MrEngineerET/roboClean/Documentation/Images/Progress/Final Hardware/DSC_0028.JPG

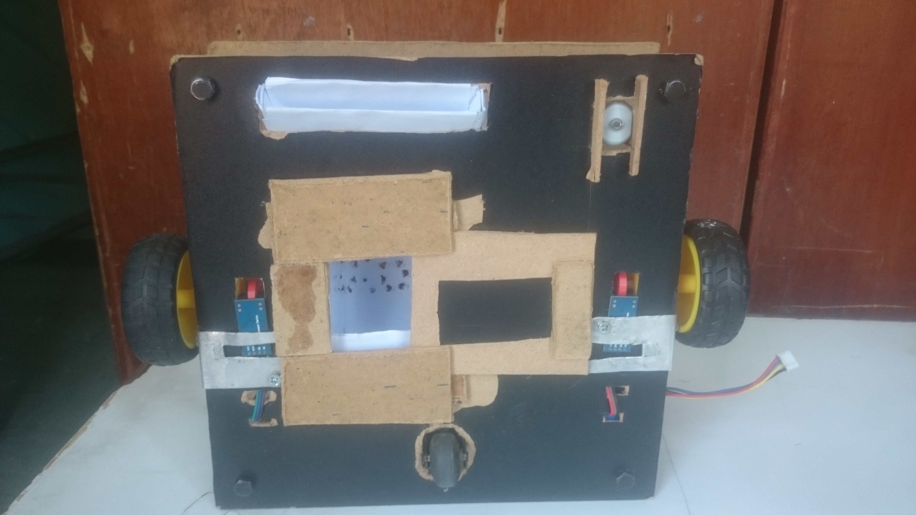
Documentation/Images/Progress/Final Hardware/DSC_0028.JPG
