MrEngineerET/roboClean/Documentation/Images/Progress/Hardware/phase three/photo_2020-12-10_14-24-15.jpg

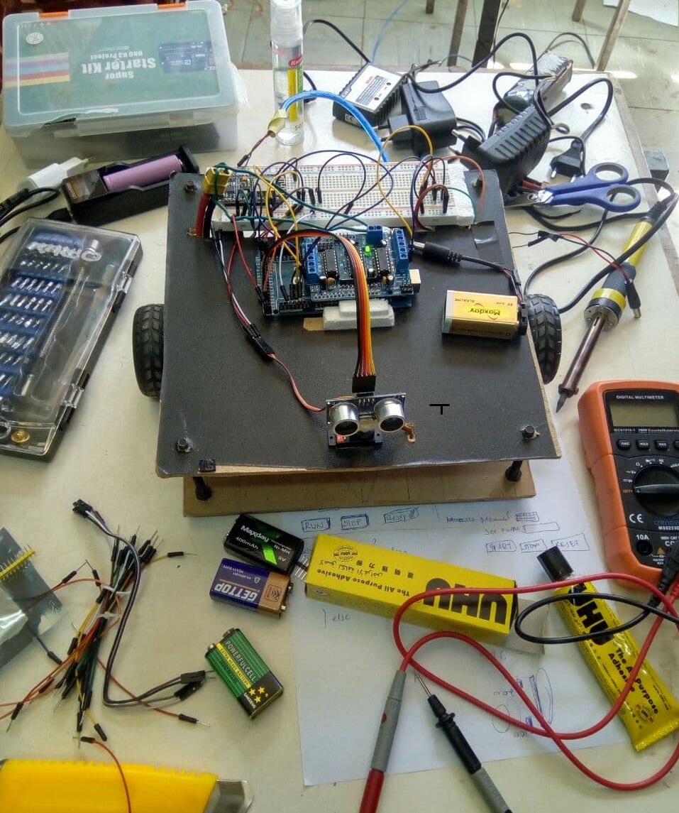
Documentation/Images/Progress/Hardware/phase three/photo_2020-12-10_14-24-15.jpg
