MrEngineerET/roboClean/Documentation/Autonomous Vacuum Cleaner Robot -Thesis presentation.pptx

## Autonomous Vacuum Cleaner Robot

Biruk Berhanu
Advisor: Mr. Kinde Mekuria

## Overview

- Introduction
- Background
- Problem statement
- Objectives
- Methodology
- Mathematical Modeling

- Odometry
- Control System Design
- Simulation/Design
- Result and Discussion
- Conclusion
- Future Work

## Introduction

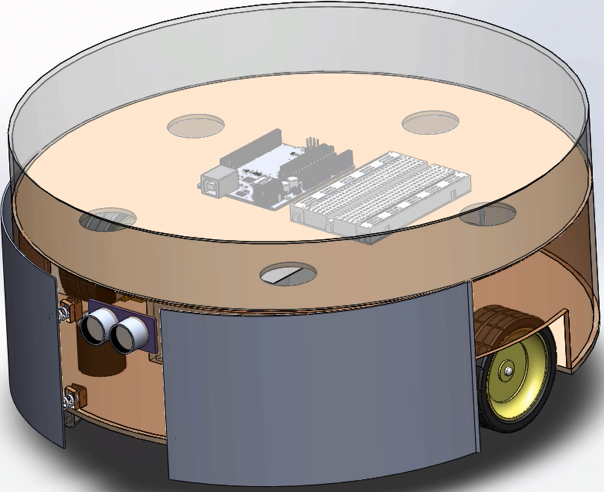
[picture p3: figure]

- It uses vacuum to clean dirt
- It navigates both autonomously and manually
- Can be Implemented at low cost using readily
available material

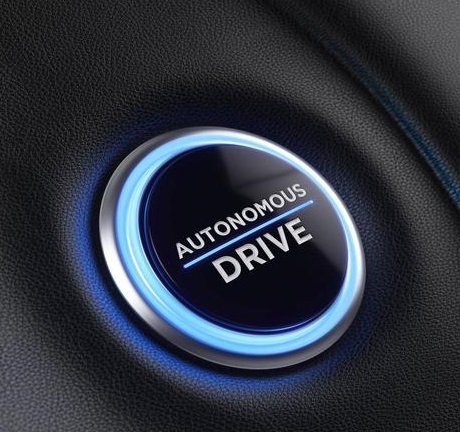
[picture p4: figure]

## Introduction Cont’d

- Theoretical Background
  - Mathematical Modeling
  - Control Theory
  - Sensing

  - localization
  - Mapping
  - Path Planning

## Background

- Roomba is one of the most widely used vacuum cleaning robots
- Other brand costs
between $400-$900

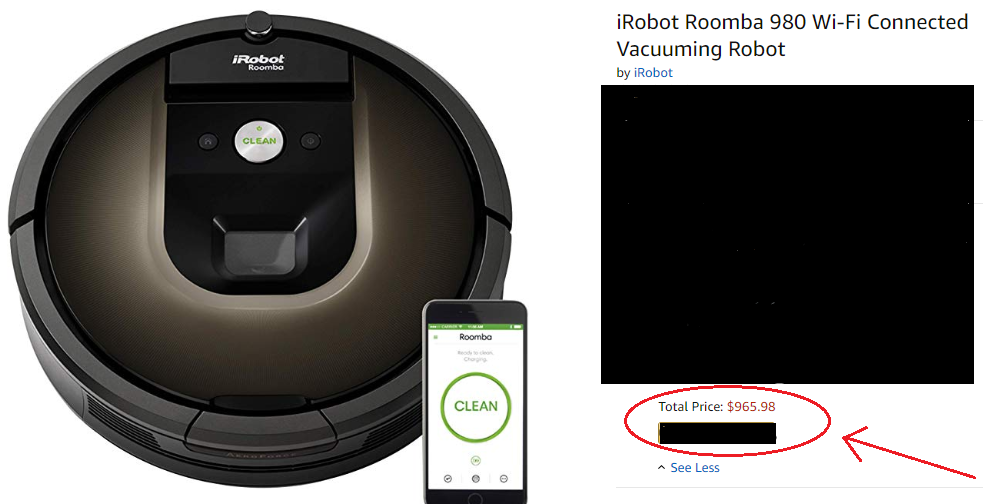
[picture p5: figure]

## Background Cont’d

- T.B. Asafa, T.M. Afonja, E.A. Olaniyan, H.O. Alade October
2016 Ladoke Akintola University of Technology, Nigeria
- CesNieto : https://www.instructables.com/id/Build-Your-Own-Vacuum-Robot/

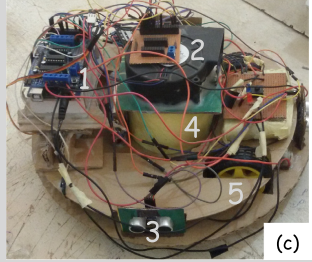
[picture p6: figure]
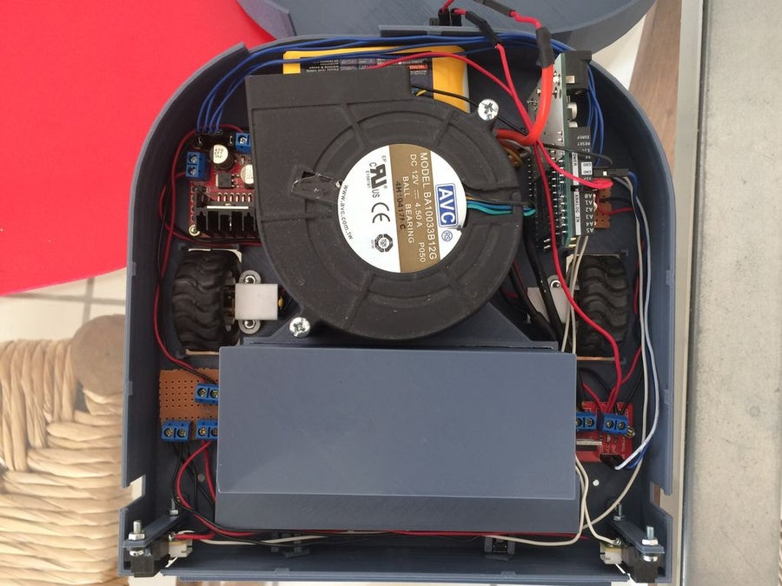
[picture p7: figure]

## Problem statement

- Price of the vacuum cleaner in the market
- The research made in university and technology enthusiast
  - Big in size
  - Low vacuum cleaning power
  - Inefficient algorithm for navigation

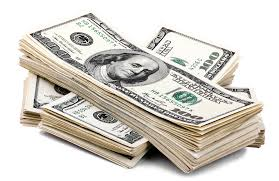
[picture p8: figure]

## Objectives

  - Low Price
  - Efficient navigation
  - Small in Size
  - Power efficient

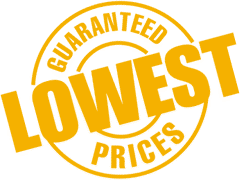
[picture p9: figure]

## Methodology

Driving Mechanism
  - Two DC motor controlled wheel
  - One caster wheel for balancing
at the bottom rear

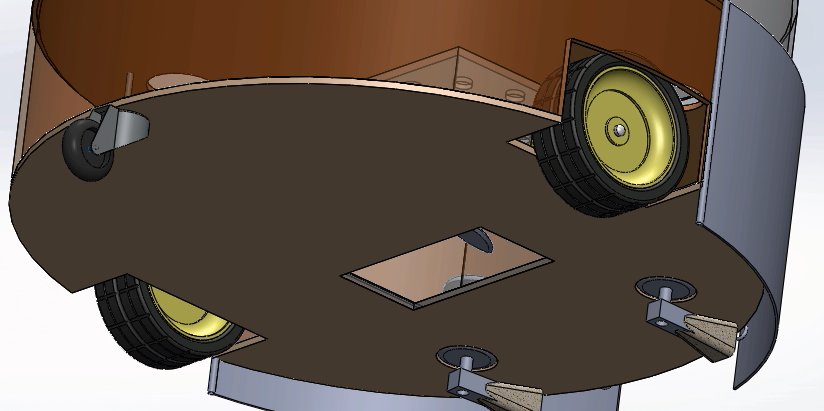
[picture p10: figure]

## Methodology Cont’d

- Cleaning Mechanism
  - One DC-motor driven for creating
a vacuum region
  - One DC-motor driven sweeper

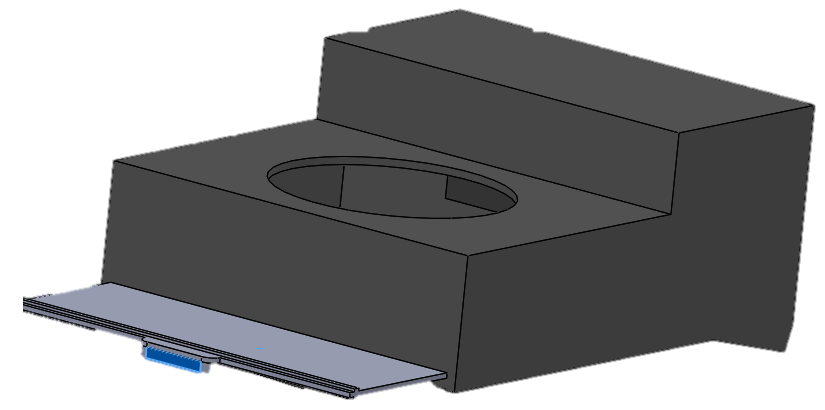
[picture p11: figure]
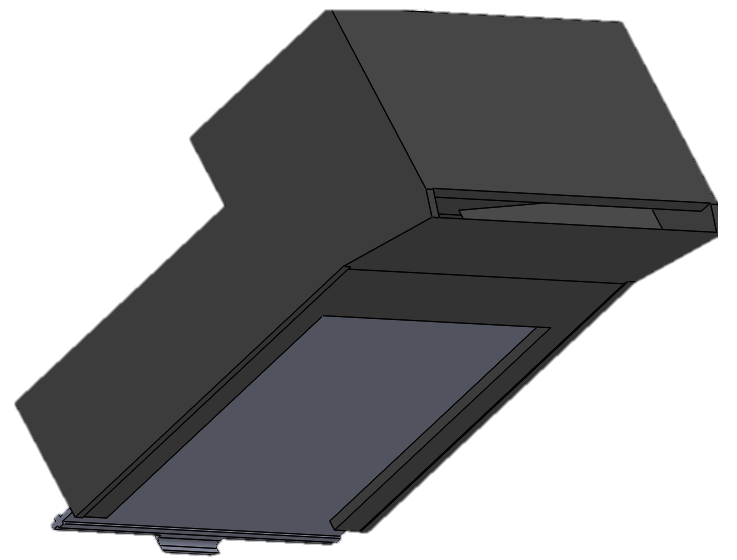
[picture p12: figure]

## Methodology Cont’d

- Navigation
  - Two mode of operation
    - Autonomously
    - Manually using Web
Random Walk
  - The robot navigates freely
without any control.

## Methodology Cont’d

- Controlled path(Method 1)
  - The robot moves only
orthogonally to the wall
  - uses the whole room as
one rectangle

## Methodology Cont’d

- Controlled path(Method 2)
  - Divide the house into numbers
of rectangles

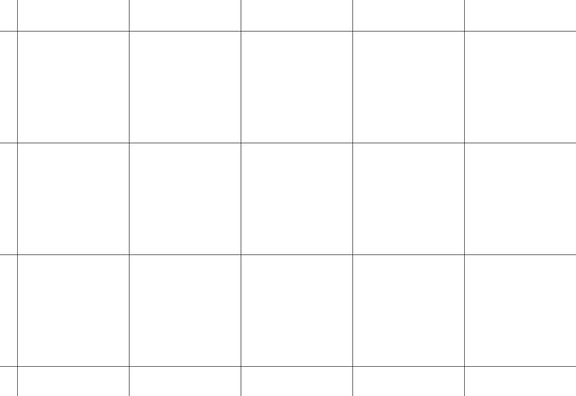
[picture p13: figure]

## Mathematical Modeling

- Modeling the robot as a differential drive robot
- The differential drive is a two-wheeled drive
with independent actuators for each wheel.
        - x`=1/2(Vr+Vl)cosφ
        - y`=1/2(Vr+Vl) sinφ
        - φ`=1/L ( Vr+Vl )

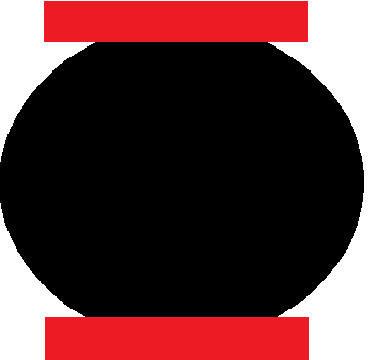
[picture p14: figure]

L

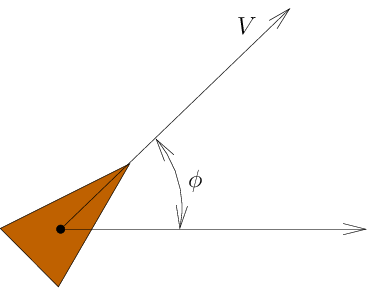
[picture p15: figure]

## Mathematical Modeling Cont’d

Simplification to the modeling
- Using Unicycle Modeling
        - x`=Vcosφ
        - y`=Vsinφ
        - φ`=ω

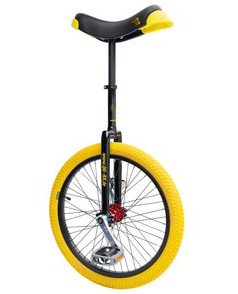
[picture p16: figure]

## Mathematical Modeling Cont’d

Design Model Implementation model
x`=Vcosφ x`=((Vr+Vl)/2)cosφ
y`=Vsinφ y`=((Vr+Vl)/2)sinφ
φ`=ω φ`=(Vr−Vl)/L
Using these two equation we can get the relation from (V,w) to (Vr,Vl)
Vr=(2V+ ωL)/2
Vl=(2V− ωL)/2

## Mathematical Modeling Cont’d

- Even though the Unicycle modeling makes a simplification to our work, It is still not convenient for solving path planning problem
High Level Modeling

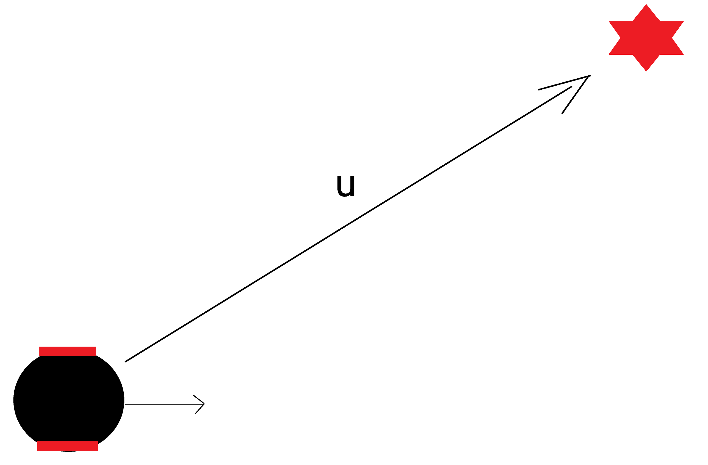
[picture p17: figure]

p `=u, x∊ R²
u=[u_x ,u_y ]
x`=[x_1 ,y_1 ]

## Mathematical Modeling Cont’d

- φ_d =atan⁡((u_y)/(u_x))
- V= √(u_y +u_x)
- ω=PID(e)=K_p e+ K_i ∫_0^τ e(t)dτ+(K_d e(t))/(dt) e= φ_d − φ

## Odometry

- where am I ?
- Where am I heading ?
Ans: Wheel encoder ( both for heading and position )

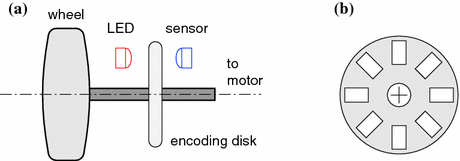
[picture p18: figure]

## Odometry Cont’d

x`=x+d_(center) cosΘ
y`=y+d_(center) sinΘ
Θ`= Θ+ φ
φ= (d_(right) −d_(left) )/L

## Odometry Cont’d

How do we calculate dr, dl ?
Ans:
D = 2 π R(Δtick /N)
Where R is radius,
N is number of opening slots in the encoding disk,
D is either dl or dr with a respective Δtick,

## Control System Design

I used PID controller for controlling the motion of the robot.

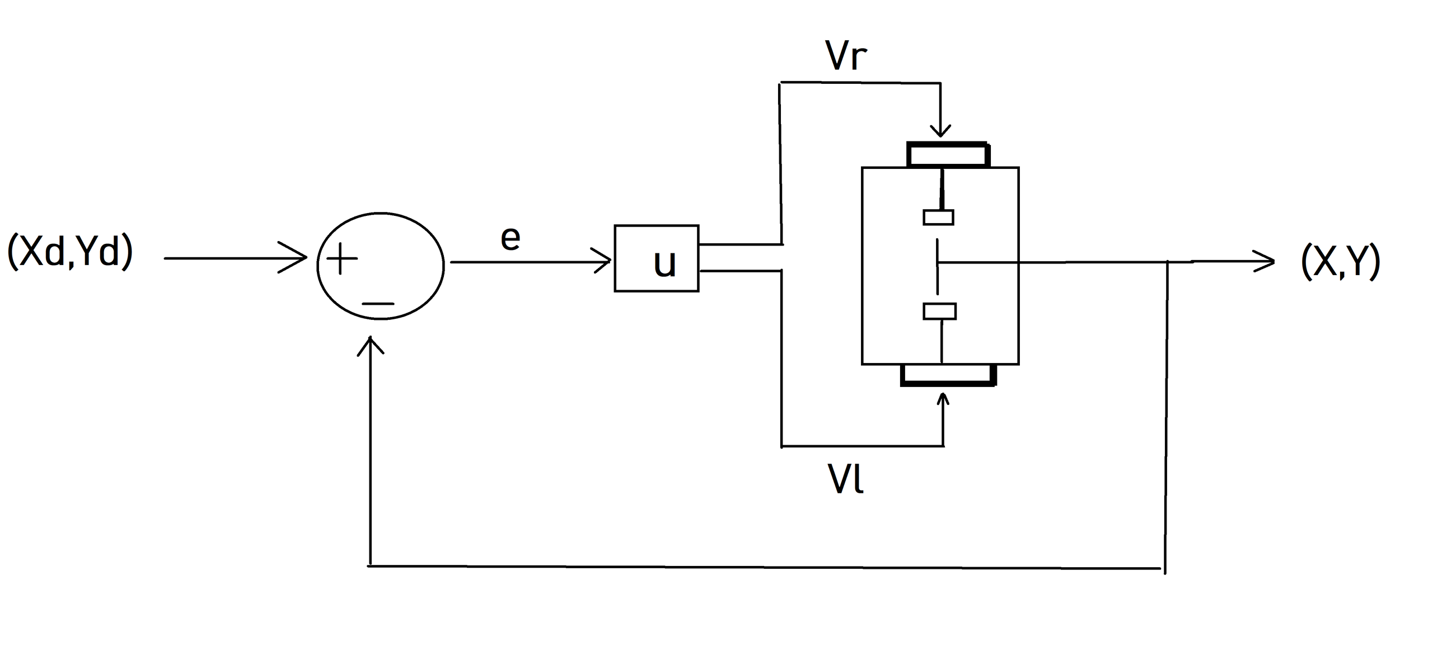
[picture p19: figure]

## Result

Go To Goal Behavior
With PID parameters of
Kp = 2
Ki = 0.05
Kd = 0

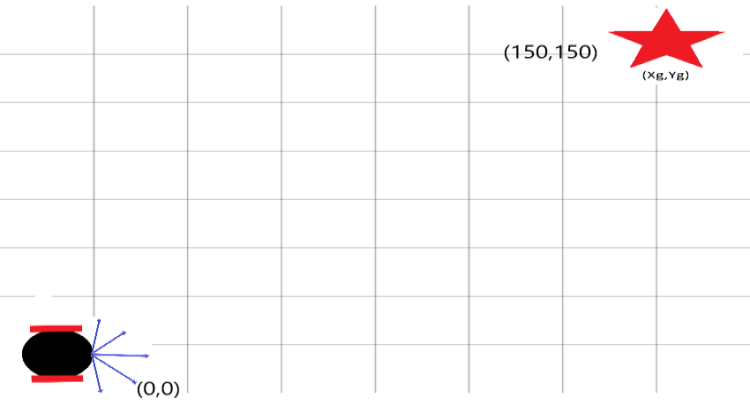
[picture p20: figure]

## Slide 24

- Position of the robot

Result cont’d (Go To Goal Behavior)

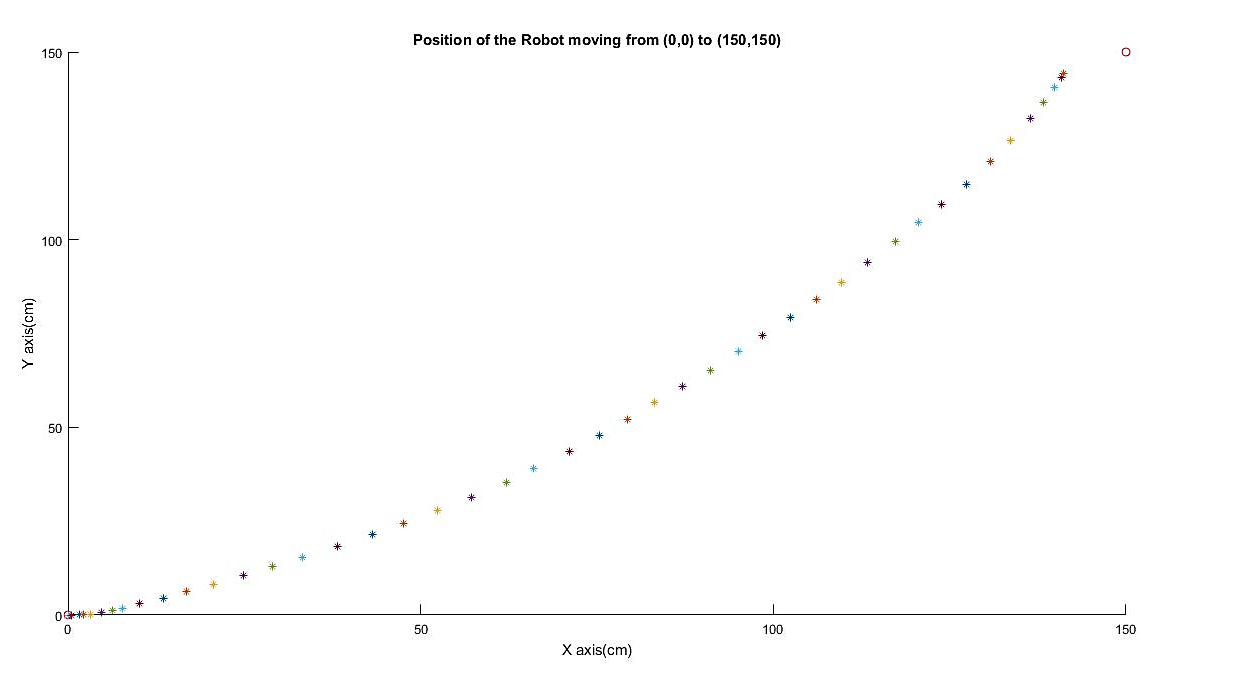
[picture p21: figure]

## Result cont’d (Go To Goal Behavior)

Tracking of the angle response

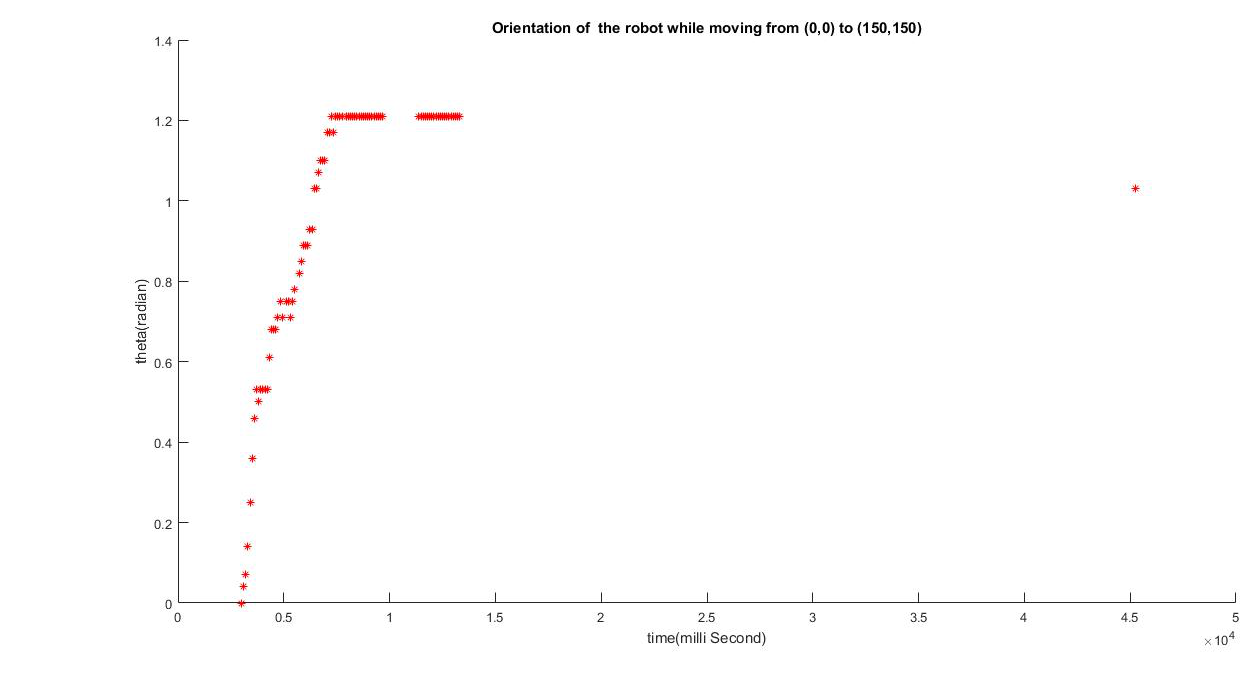
[picture p22: figure]

## Result cont’d (Go To Goal Behavior)

Robot moving a straight line from position from x = 50 and y = 0 to goal position x = 300, and y = 0, with PID parameter of Kp = 20, Ki = 10, Kd = 5

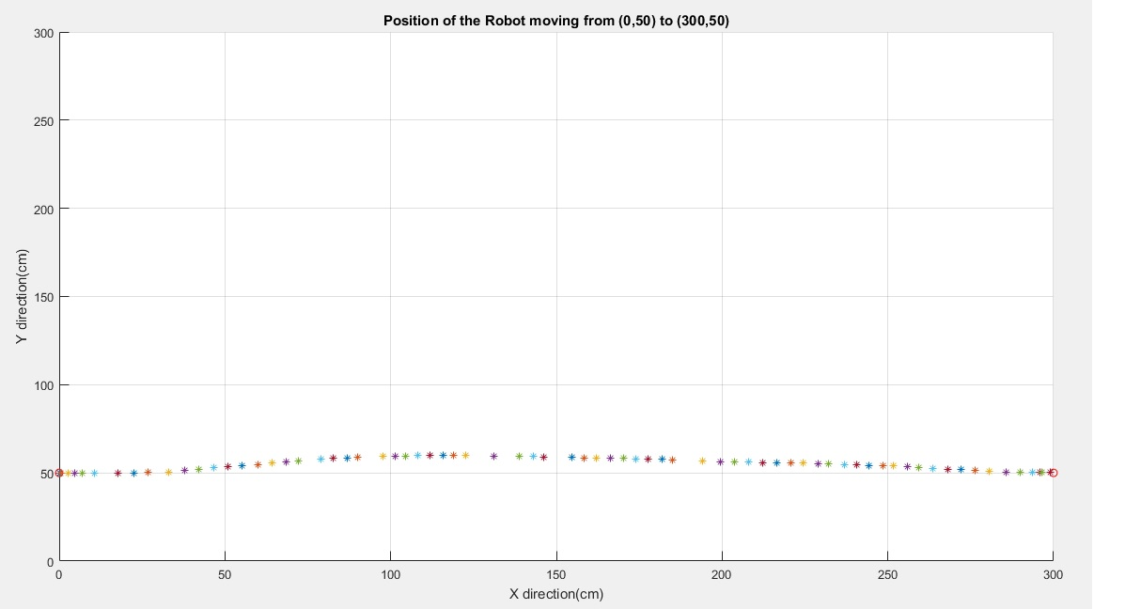
[picture p23: figure]

## Result ( Hardware design )

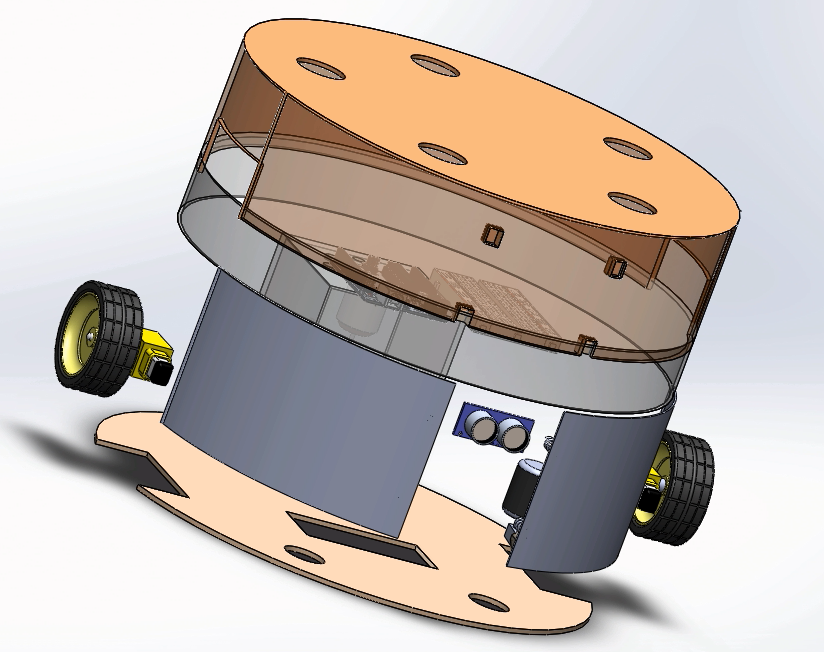
[picture p24: figure]
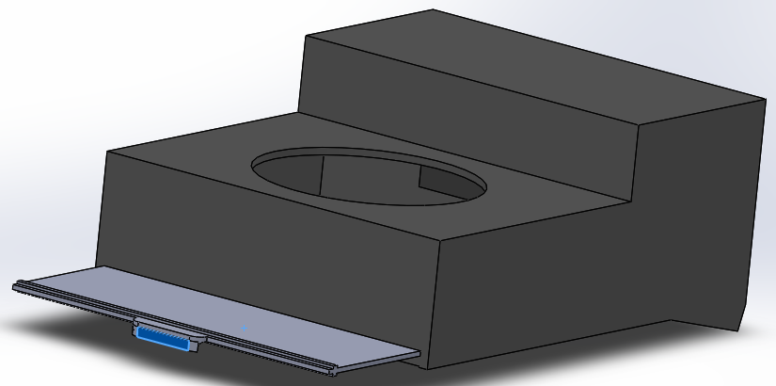
[picture p25: figure]

## Result ( Hardware Model )

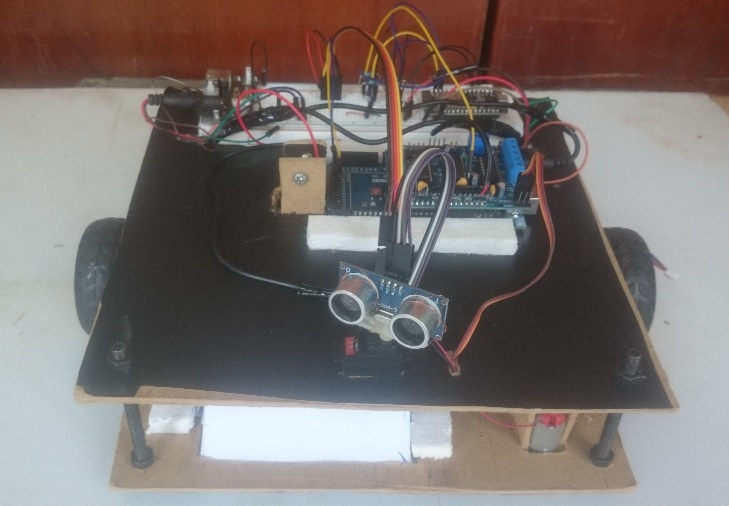
[picture p26: figure]
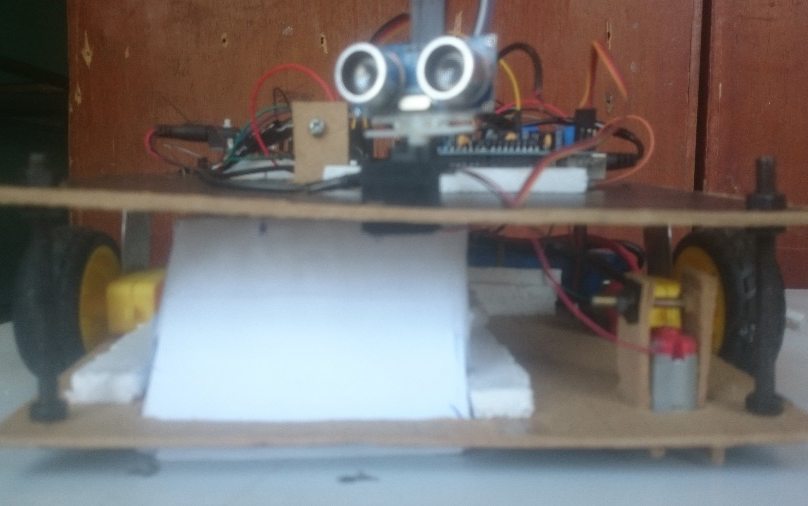
[picture p27: figure]

## Result (Hardware Model)

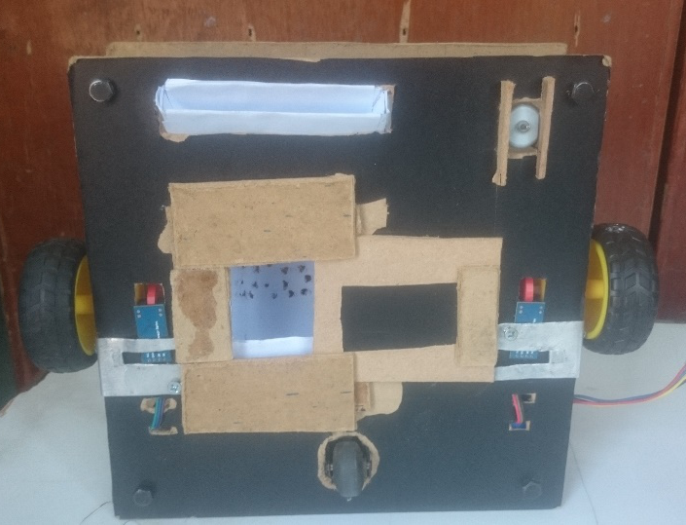
[picture p28: figure]
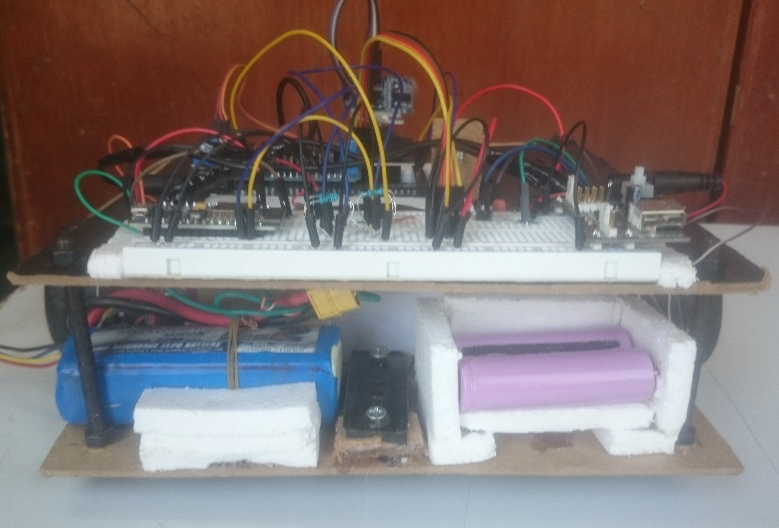
[picture p29: figure]

## Conclusion

- Satisfactory result on Odometry and Go-To-Goal behavior
- Have most of the features of a conventional vacuum cleaner
- Very challenging building a fully functional mobile robot by homemade material, I advice to use quality products.

## Future work

- SLAM( Simultaneous Localization And Mapping)
  - Need high computational power processor. (at least raspberry pi)
  - Need a LiDAR sensor
- Docking station for charging and position recalibration
- Application for managing its various feature
  - Security
  - Different power usage mode

## Slide 32

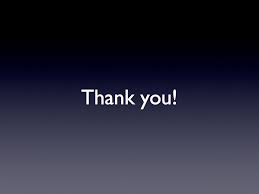
[picture p30: figure]
