MrEngineerET/roboClean/Documentation/Differential drive/mobkin.pdf

# Mobile Robot Kinematics

We’re going to start talking about our mobile robots now. There robots differ from our arms in 2 ways: They have sensors, and they can move themselves around. Because their movement is so different from the arms, we will need to talk about a new style of kinematics: Differential Drive.

1. Differential Drive is how many mobile wheeled robots locomote.
2. Differential Drive robot typically have two powered wheels, one on each side of the robot. Sometimes there are other passive wheels that keep the robot from tipping over.
3. When both wheels turn at the same speed in the same direction, the robot moves straight in that direction.
4. When one wheel turns faster than the other, the robot turns in an arc toward the slower wheel.
5. When the wheels turn in opposite directions, the robot turns in place.
6. We can formally describe the robot behavior as follows:
(a) If the robot is moving in a curve, there is a center of that curve at that moment, known as the Instantaneous Center of Curvature (or ICC). We talk about the instantaneous center, because we’ll analyze this at each instant- the curve may, and probably will, change in the next moment.
(b) If r is the radius of the curve (measured to the middle of the robot) and l is the distance between the wheels, then the rate of rotation (ω) around the ICC is related to the velocity of the wheels by:

ω(r +

l
2

) = vr

ω(r −

l
2

) = vl

Why? The angular velocity is defined as the positional velocity divided by the radius:
dθ
dt =

V
r

This should make some intuitive sense: the farther you are from the center of rotation, the faster you need to move to get the same angular velocity. If you travel at π radians per second for 1 second, you should travel a distance of half the circumference, or πr. Since this was in one second, the velocity was πr per second. So π radians per second equals πr velocity, so v = ωr. Once we have those equations, we can solve for r or ω:

vr = ω(r +

l
2

)

= ωr + ω

l
2

vl = ω(r −

l
2

)

= ωr − ω

l
2
subtract the two equations

vr − vl =

2ωl
2

ω =

vr − vl
l

From the left column:

vr = ωr + ω

l
2

vl = ωr − ω

l
2
add the two equations
2ωr = vr + vl

r =

l(vr + vl)
2(vr − vl)

Things to note:

i. angular velocity is the difference in the wheel speeds over their distance apart. ii. if vr = vl
, then ω is 0, the robot moves straight. iii. if vr = −vl
, then r is 0 and the robot spins in place.
7. The robot is, at any one time at a location x, y, and facing a direction which forms some angle θ with the x-axis of the reference frame.Defining θ = 0 to be the robot facing along the positive x-axis keeps us consistent with mathematical tradition but has an additional consequence. As the robot moves, its local frame moves with it, so θ is the angle between the reference frame x-axis and the local frame x-axis. The triple x, y, θ is called the pose of the robot.

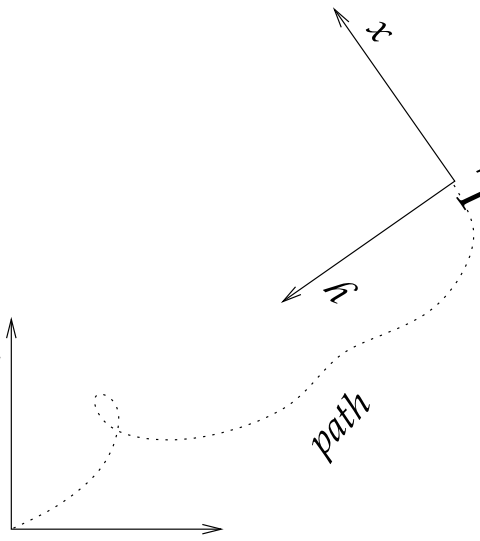
[picture p105: figure]
path

L

R

y

x

(A mobile robot began at the reference frame origin and as it moved, its local frame moved with it)

8. The forward kinematic problem is: given a robot at some pose, and moving at some angular velocity ω during a time period δt, determine the new pose for the robot.
(a) First, note that all of these elements are functions of time: x(t), y(t), ω(t), V (t), θ(t).
(b) Next, lets calculate where the ICC is, given r. In the (currently non-existent) figure, the robot is facing in a direction indicated by the ray ~pf. The ray is tangent to the curve being traversed by the robot at that moment, so the segment from p to ICC is perpendicular to ~pf. ∆x and ∆y make up the right triangle, and:

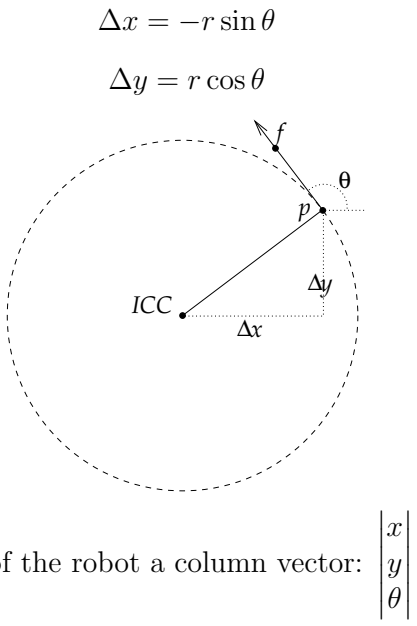
[picture p106: figure]
∆x = −r sin θ; ∆y = r cos θ; ICC

(c) We’ll represent the pose of the robot a column vector:

(d) To calculate the new location we’ll perform the following steps: start at the reference frame, translate out to the original position (RTP0
). Rotate to the current
pose (position plus orientation) P0 TPθ
. Translate to the ICC (Pθ TICCθ ). Rotate
around the ICC (ICCθ TICCω

). Finally, translate back out (ICCω TN . This gives us the new position of the robot.
(e) This is given by the equation:

RTN =

RTP0 ×

P0 TPθ ×
Pθ TICCθ ×

ICCθ TICCω ×

ICCω TN .

RTN =

2

6
6
4
1 | 0 | 0 | x
0 | 1 | 0 | y
0 | 0 | 1 | 0
0 | 0 | 0 | 1

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
cos θ | − sin θ | 0 | 0
sin θ | cos θ | 0 | 0
0 | 0 | 1 | θ
0 | 0 | 0 | 1

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
1 | 0 | 0 | 0
0 | 1 | 0 | r
0 | 0 | 1 | 0
0 | 0 | 0 | 1

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
cos ωδt | − sin ωδt | 0 | 0
sin ωδt | cos ωδt | 0 | 0
0 | 0 | 1 | ωδt
0 | 0 | 0 | 1

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
1 | 0 | 0 | 0
0 | 1 | 0 | −r
0 | 0 | 1 | 0
0 | 0 | 0 | 1

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
cos θ cos ωδt − sin θ sin ωδt | − cos θ sin ωδt − sin θ cos ωδt | 0 | r cos θ sin ωδt + r sin θ cos ωδt + x − r sin θ
sin θ cos ωδt − cos θ sin ωδt | − sin θ sin ωδt − sin θ sin ωδt | 0 | r sin θ sin ωδt − r cos θ cos ωδt + y + r cos θ
0 | 0 | 0 | θ + ωδt
0 | 0 | 0 | 1

3

7
7
5

(1)

where the rightmost column is the x, y and θ.

9. Note that vl and vr are really functions of time vl(t) and vr(t) (they change over time as the robot moves in different ways) thus, r and ω are both also functions of time r(t) and ω(t). 9
(a) Because we don’t have nice expressions for these functions, what we normally do is break the robot’s actions up in to periods of time where vl and vr are constant, and thus can be replaced with a single number. Once we have those single numbers, the above formula’s are easy to calculate.
(b) But, thinking about these parameters as functions gives us another way to derive these equations; a way that many feel is simpler. In this method, we note that the functions of x, y, θ depend on the functions of the velocity V (t) and the angular rotation ω(t):
x(t) = Z t
| 0

V (t) cos[θ(t)]dt

y(t) = Z t

| 0

V (t) sin[θ(t)]dt

θ(t) = Z t

| 0

ω(t)dt.

(c) In the case of a differential drive robot, V (t) = vr(t)+vl(t)
| | | 2

, the average of the two
wheels, and we know ω(t) from above. Thus with substitution, the equations become:
x(t) = 1
2

Z t

| 0
[vr(t) + vl(t)] cos[θ(t)]dt | (2)

y(t) = 1
2

Z t

| 0
[vr(t) + vl(t)] sin[θ(t)]dt | (3)

θ(t) = Z t

| 0
ω(t)dt. | (4)

(d) Again, we don’t have descriptions of these functions, but if we assume that vl and vr are constant, then we can substitute in:

θ(t) = Z t

0

vr − vl
l

dt.

=

vr − vl
l

Z t

0

1dt.

=

vr − vl
l
t | (5)

Then we can substitute this back into the other two equations:

x(t) = 1
2

Z t

0

[vr + vl

] cos[vr − vl
l

t]dt

=

vr + vl
2

Z t

0

cos[vr − vl
l

t]dt

=

vr + vl
vr − vl

l
2

sin[vr − vl
l

t]

t

0
=

vr + vl
vr − vl

l
2

sin[vr − vl
l

t] −

vr + vl
vr − vl

l
2

sin[vr − vl
l

0]

=

vr + vl
vr − vl

l
2

sin[vr − vl
l
t] | (6)

and

y(t) = 1
2

Z t

0

[vr + vl

] sin[vr − vl
l

]dt

=

vr + vl
2

Z t

0

sin[vr − vl
l

]dt

= −

vr + vl
vr − vl

l
2

cos[vr − vl
l

t]

t

0
= −

vr + vl
vr − vl

l
2

cos[vr − vl
l

t] − −

vr + vl
vr − vl

l
2

cos[vr − vl
l

0]

= −

vr + vl
vr − vl

l
2

cos[vr − vl
l

t] + vr + vl
vr − vl

l
2

(7)

(e) Why aren’t these the same as the equations from (1)? They are, we just have to perform the same substitutions we did for the integral case, plus account for assumptions in the integral equations. Recall that:

x(t) = r cos θ sin ωδt + r sin θ cos ωδt + x − r sin θ if vr and vl are constant,

ω =

(vr − vl)
l

, so

x(t) = r cos θ sin[(vr − vl) l

δt] + r sin θ cos[(vr − vl) l

δt] + x − r sin θ.

r =

l(vl + vr)
2(vr − vl)

, so

x(t) = l(vl + vr)
2(vr − vl)

cos θ sin[(vr − vl)
l

δt] + l(vl + vr)
2(vr − vl)

sin θ cos[(vr − vl)
l

δt] + x − r sin θ.

Note that in the integral equations, we started from time 0, so therefore, the original angle θ is 0.
x(t) = l(vl + vr)
2(vr − vl)

sin

(vr − vl)
l

δt + x.

and
δt = t and x = 0, resulting in, x(t) = l(vl + vr)
2(vr − vl)

sin

(vr − vl)
l

t.

which is the same as from eq (6)

10. Important Note: Since equations (5), (6), and (7) were derived using the assumption that the period in time under discussion began at time 0. At time 0, the robot’s pose is h0, 0, 0i. Therefore those equations give us the pose of the robot with respect to the robot’s pose at the beginning of the time period. We’ve seen this before, haven’t we? The calculated pose is with respect to a local coordinate frame set to the robot’s position at the start of the time period. We can then calculate the pose of the robot with respect to our reference frame using our old formula: RTN × N p = Rp.
11. In all of this analysis, it was assumed that vr 6= vl
. Otherwise r would be infinite, and the equations are not valid. When these two are equal, we need to derive different equations. Starting from eqn (4), we note that θ(t) is not longer a function of time, since θ never changes. Since we’re deriving these in terms of the local frame, θ(t) = 0.

Plugging this into equations (2) and (3) plus vr = vl = v, we get:

x(t) = 1
2

Z t

0

[v + v] cos[θ]dt

y(t) = 1
2

Z t

0

[v + v] sin[θ]dt

so,
x(t) = vδt | (8)
y(t) = 0 | (9)
θ(t) = 0 | (10)
12. Putting it all together
(a) Calculating the forward kinematics of the robot as it moves keeps track of the robot’s location- something useful for the robot to know. What we need to do now is combine these equations into an algorithm we can use directly.
(b) There are many ways to keep track of the robot’s position. One Basic algorithm:
i. The robot starts with a pose: h0, 0, 0i.
ii. Generate the identity matrix and store as the transformation from the reference frame to the current frame: RTC.

iii. Divide the time the robot is moving into time periods where the wheel velocities are constant.
iv. For each time period:
A. Use equations (5), (6), and (7) to calculate the new pose: hx, y, θi.
B. Calculate the transform from the reference frame to the new frame:

RTN =

RTC ×

CTN | (11)

This is the new pose of the robot in the reference frame. Store it as the current frame:

RTC =

RTN .

v. After any pass through the loop, RTC describes the pose of the robot in the rightmost column.
13. Final note: Often programmers, when they treat the case of equal wheel velocities, combine equations (8) (9) (10) with equation (11) to give:
x = v cos(θ)δt | (12)
y = v sin(θ)δt | (13)
θ = θ | (14)

where hx, y, θi is the pose in the reference frame .

14. Inverse Kinematics. The inverse kinematics problem is, given an x,y,θ (and possibly a δt), find the vr and vl that gets the robot there. As we can see from equations
(6) (7) (5), the problem is under constrained: there are infinitely many vr and vl values for any x, y and θ. Solutions for these can be found if we apply additional constraints, for instance...
(a) if we assume that vr = vl = v, then the problem is much easier, because it is over constrained (see (8) (9) (10)). The robot can not get to certain (x, y) positions, or change its orientation.
(b) If we assume −vr = vl

, then equations (2), (3), (4) become:

x(t) = 0
y(t) = 0

θ(t) = ±

2vδt
l

The problem is again over constrained because although the robot can achieve any orientation, it is fixed in place.

(c) But if we combine these constraints in sequence, the robot can get anywhere by spinning in place until it is facing the right direction, then traveling in a straight line to the correct position, and finally spinning in place until the correct pose is reached. This is one simple solution to the inverse kinematics problem. We would like to not have to impose these constraints because the movement looks a little funny, but this makes the mathematics much easier.
(d) If there are obstacles in the way, then this technique won’t work. This is a harder problem, known as the path planning problem, and we will address it later.
