MrEngineerET/roboClean/Documentation/RoboClean DocumentationVersion1.docx

Addis Ababa University

Addis Ababa Institute of Technology

School of Electrical and Computer Engineering

Autonomous Vacuum Cleaner Robot

By: Biruk Berhanu

Advisors’ Name: Mr. Kinde Mekuria

Date of submission:

# Chapter 1 Contents

# Chapter 1 Overview

## 1.1 Abstract

We are in the age of the new era, which is the age of the digital world. Almost everything has become autonomous and accompanied by AI. I strongly argue not to do house chores manually since we have already passed the manual age. There is some progress in building an Autonomous vacuum cleaner robot to clean our houses merely without any help from people. But current Vacuum cleaner robots are somewhat expensive and inefficient. “It is, therefore, a sine qua non to improve the technology of vacuum cleaning to reduce these deficiencies”( T.B. Asafa, Development of a vacuum cleaner robot, p.1).

In this thesis I present the development of compact, efficient, and cheap vacuum cleaner robot. The robot will be disk-shaped, equipped with vacuuming and cleaning technology and controlled by Arduino Mega microcontroller. It sucks dirt via a retractable dustbin on top of which a cooling fan is mounted, and one sweepers driven by DC motor. The robot navigates using two DC geared motor mounted at the center axis of the robot. There will also be a third rear caster wheel which is used for balancing and ease of control. The robot will be modeled using differential drive model. The perception of the robot is accompanied by one ultrasonic module mounted on a servo simulating a radar and two optical encoders connected to the two-axis wheel to count the number revolution made by the wheel.

## 1.1 Acknowledgment

I would wish to express my special thanks of gratitude to my advisor Mr. Kinde Makaria who gave me the opportunity to do this project on the topic Autonomous Vacuum Cleaner Robot, which also helped me in understanding a lot of ideas and approach. Secondly, I would also like to thank my friends from mechanical engineering department who helped me on designing the structural aspect of the robot.

## 1.2 Acronym

RoboClean ---- Robot Cleaner

DC --- Direct Current

pose --- position and orientation

## 1.3 Introduction and Background

A very notable household chore is floor cleaning which is usually considered as unpleasant, difficult, awkward and boring. In most cases, cleaners are hired to do the task rather than the household residents do it. The discomfort posed by this recurrent chore necessitated development of a vacuum cleaner that could assist human with such a task. A vacuum cleaner is an electromechanical appliance commonly used for cleaning floors, furniture, rugs and carpets by suction. An electric motor inside the appliance turns a fan which creates a partial vacuum and causes outside air to rush into the evacuated space. This forces any dirt or dust near the nozzle into a bag inside the machine or attached to the surface(Asafa et al. 2018).

The robotic vacuum is mainly built from an easily available material and limited number electronic devices. The robotic vacuum uses a rotating sweeper underneath the unit to vacuum a floor as it passes over it. Two DC motors, aligned across the center axis of the robot, are used to accurately drive the robotic vacuum around a room. Because the body of the robot is circular and the DC are placed along the center axis, the robot can spin in place in any direction. One caster wheel is located at the rear of the robot to keep it balanced.

The robot is programmed to sense the direction of a collision with an obstacle using an ultrasonic sensor mounted on a servo motor. The robotic vacuums movement is based upon two navigations strategies. The first one is a random walk around a room, which theoretically will cover the entire area of a room given enough time. The robot uses the ultrasonic sensor to avoid obstacle. It moves in a strait direction until it faces an obstacle then It will make a random angle turn and drive away from the obstacle. The second approach to the navigation problem is to drive the robot in a predefined path. The robot will track of the position and orientation as it maneuvers. In addition, it will also avoid an obstacle and get back to the predefined paths.

## 1.4 Literature Review

During my research on previously made vacuum cleaner robots, I found out that there has not been made a significant investigation on this area of subject specifically. I think this is due to the behavior of the subject field. Autonomous vacuum cleaner is a subject composed of control theory, path planning, Artificial intelligence, electronic circuit design and mechanical design. There are significant amounts of research papers on the individual aspect of the above subjects. The goal of this literature review is to compare the different approach studied by each field.

### 1.4.1 Mechanical Design


There are some different mechanisms to implement the platform(chassis) of the robot. For example, Differential Drive, Skid steering, Tricycle Drive, Ackermann steering.

- Differential Drive: This is the most common control mechanism for robot builders, especially for beginners. The concept is simple; Velocity difference between two motors drive the robot in any required path and direction. Hence the name “Differential” drive. Differential wheeled robot can have two independently driven wheels fixed on a common horizontal axis or three wheels where two independently driven wheels and a roller ball or a castor attached to maintain equilibrium.


- Tricycle Drive : Tricycle robot is designed with a front steering wheel controlled by a motor. The two rear wheels are attached to a common axle driven by a single motor with two degrees of freedom (either forwards or reverse). The disadvantage is that they cannot spin like a differential drive robot and does not have a 90° turn due to their limited radius of curvature. Few robots have both steer and drive controlled by the front wheel and the rear wheels act as supporting wheels to maintain equilibrium. Due to the design constraints and its drawbacks, this design is less appreciated by the robot building community.


- Ackermann steering: One of the most common configurations found in cars is Ackerman steering which mechanically coordinates the angle of two front wheels which are fixed on a common axle used for steering and two rear wheels fixed on another axle for driving. The advantage in this design is increased control, better stability and maneuverability on road, less slippage and less power consumption. This might resemble the tricycle approach where the front wheel is replaced with two wheels and an axle. But when two wheels are attached to a tricycle design (axle-articulated drive), then turning causes the robot to skid. To overcome that drawback Ackerman steering is designed in such a way that when there is a turn, the inner tire turns with a greater angle than the outer tire and avoids tire slippage. This approach can be generally used for fast outdoor robots which require excellent ground clearance and traction. Although there are disadvantages, the downside is additional parts required; no zero radii turn and increased complexity in design. (http://www.robotplatform.com/knowledge/Classification_of_Robots/wheel_control_theory.html)

### 1.1.1 Control Theory

Mobile robots perform their intended task usually in a dynamic environment, this implies that the control for this kind of system is complex. One of the most chosen approach is to divide and conquer the different possible occurrence of environment and to design a control for each possibility. This approach is well studied and is called Behavior-Based-Robotics.

Behavior-Based-Robotics [adddd]

### 1.4.2 Path Planning

Path-planning is an important task for mobile robots that lets robots find the shortest path between two points. The algorithm implementing the path planning should also choose an optimal path. Optimal paths are those that minimize the amount of turning, breaking or whatever a specific application requires. Map of the environment and the awareness of the robot’s location with respect to the map are the requirement for path planning. A*, D*, and RRT are the most commonly used path-planning algorithm.

## 1.5 Problem Statement

Currently, in an urban area, most people spent their time doing their day to day jobs. In addition to their day to day jobs, they are also required to do their household chores. Naturally, household chores are boring and it would not be fair for a person to engage in such kind of task after a long working day. A vacuum cleaner robot will eliminate one of the tiresome chores, which is cleaning a house. Therefore, a lot of busy people would benefit from the autonomous vacuum cleaner.

Cleaning of these offices and buildings happen at dawn, which is a time when peoples start to crowd the place. During this time there is a smell of dust and detergent, which is very uncomfortable and unhealthy. However, most offices and buildings are not used at night. Therefore, if cleaning is made at the time when there are no people, for example starting from midnight, it would eliminate the above problem. The solution can be achieved using an autonomous vacuum cleaner robot.

Cleaning home has never been easy for older peoples and disables. They need a form of a robot that performs the task. Implementing the vacuum cleaner robot would help a lot with such kind of community.

Depending on the design target, robotic vacuum cleaners are appropriate for offices, hotels, hospitals, and homes. However, most cheap cleaners need a better cleaning pattern algorithm for efficient functioning while the smart ones are rather costly, and thus beyond the reach of most homes. These challenges were carefully considered while designing the robot vacuum cleaner described in this paper(Asafa et al. 2018).

As a final project, I made a decision to design and build a robot capable of vacuuming the floor of a room or area with no human interaction aside from just starting the unit. I realized the need for a cheap and convenient product that can be easily used to vacuum a room on its own, saving a person valuable time.

## 1.6 Objective

Generally making a robot requires some parameters for consideration and it can have many scopes on how deep the robot is intended to do the required task. On this project, it is planned to have the following feature:

a. It will have two DC motor for its movement with the help of one caster wheel for balancing
b. It will have one motor to create a vacuum at the bottom of the robot
c. It will have one ultrasonic sensor mounted on a servo motor for obstacle detection and navigation
d. It will have one DC motor for implementing the function of sweeper
e. Two mode of operation:
  1. The first mode of operation is without any control from the external environment. This mode of operation is what makes the robot autonomous.
  2. The second mode of operation is by using an android phone to monitor and navigate incase the robot got stack at some place.

## 1.7 Thesis Organization

1. Mathematical Modeling: This chapter discuss about the mathematical model of the robot. The robot is modeled as a differential drive robot. This driving mechanism is used by a lot of mobile robots. It consists of two drive wheels mounted on a common axis, and each wheel can independently be driven either forward or backward.
2. Mechanical Structure and Electrical Hardware Design: This chapter discuss about the mechanical structure and Electrical hardware design of the robot. It consists of CAD design for the mechanical structure and schematic and circuit diagram for the Electrical hardware design.
3. Control System Design: This chapter focuses on the fundamental control of the robot. Due to performance and simplicity advantage, the control of the robot is divided into different behaviors. Behaviors are specific targeted tasks the robot performs. The robot control jumps from one behavior to another behavior based on the environment condition. The robot will have three behaviors, Go-To-Goal, Obstacle-Avoidance, and Wall-Following. The robot can navigate any kind of environment by switching from one behavior to another behavior.
4. Testing and Simulation Result: This will be the last chapter for presenting results on tests made on the different behavior of the robot, [adddddddd]

# Chapter 2 Mathematical Modeling

## 2.1 Introduction

The differential drive is a two-wheeled drive system with independent actuators for each wheel. The name refers to the fact that the motion vector of the robot is the sum of the independent wheel motions. The drive wheels are usually placed on each side of the robot and toward the front (Sanketh, 2020).

Even though differential drive robots’ benefits, there are some points to be aware of before designing our system. They are very sensitive to slight change in velocity in each wheel, small error in the relative velocities between the wheels can affect the robot trajectory. They are also very sensitive to slippery floor, and finally, caster wheels for balancing is necessary.

## 2.1 Differential Drive Kinematic

(Dudek and Jenkin, Computational Principles of Mobile Robotics)Many mobile robots use a drive mechanism known as differential drive. It consists of 2 drive wheels mounted on a common axis, and each wheel can independently be driven either forward or backward. While we can vary the velocity of each wheel, for the robot to perform rolling motion, the robot must rotate about a point that lies along their common left and right wheel axis. The point that the robot rotates about is known as the ICC - Instantaneous Center of Curvature (see figure 1)

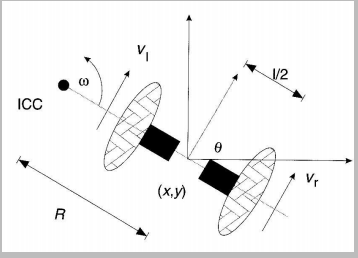
[picture p117: figure]

Figure 2:1 Differential Drive kinematics (from Dudek and Jenkin, Computational Principles of Mobile
Robotics.

By varying the velocities of the two wheels, we can vary the trajectories that the robot takes.
Because the rate of rotation w about the ICC must be the same for both wheels, we can write the
following equations:

where l is the distance between the centers of the two wheels, Vr ; Vl are the right and left wheel
velocities along the ground , and R is the signed distance from the ICC to the midpoint between the wheels. At any instance in time we can solve for R and w:

There are three interesting cases with these kinds of drives.

1. If Vl = Vr, then we have forward linear motion in a straight line. R becomes infinite, and there is effectively no rotation - w is zero
2. If Vl = - Vr, then R = 0, and we have rotation about the midpoint of the wheel axis - we rotate in place.
3. If Vl = 0, then we have rotation about the left wheel. In this case R = 2l . Same is true if Vr = 0.

## 2.2 Forward Kinematics

(Dudek and Jenkin, Computational Principles of Mobile Robotics) The forward kinematics equations for a robot (or other vehicle) with differential drive are used to solve the following problem: Standing in the pose (x, y, θ) at time t, determine the pose (x’, y’, θ’) at time t + δt given the control parameters vl and vr . The solution is typically used for automatic control of a robot such that it follows a wanted trajectory.

In General, we can describe the position of the robot capable of moving in a particular direction Θt at a given velocity V(t) as:


For the special case of a differential drive, the above equations become:

## 2.3 Reverse Kinematics

While the forward kinematics equations provide an updated pose given certain wheel speeds (or encoder counts), we can also formulate an inverse problem: Standing in pose (x,y,θ) at time t, determine control parameters vl and vr such that the pose at time t + δt is (x’,y’,θ’).

This problem most often has no solution, in the sense that the robot cannot reach an arbitrary pose by simply setting appropriate values for wheels speeds vl and vr and let the motors run for a while. For some robots and vehicles, it is possible, and these vehicles are called Holonomic. However, most vehicles and robots are non-holonomic. For instance, a car is non-holonomic and this is why pocket parking is so hard.

For a non-holonomic robot, there are ways to increase the constrained mobility. If we allow a sequence of different (Vl , Vr). There are normally infinitely many ways to move from one pose to another.

The following algorithm can be used to reach any target pose from any starting pose:

1. Rotate until the robot’s orientation coincides with the line from the starting position to the target position: Vr = – Vl = Vrot
2. Drive straight until the robot’s position coincides with the target position: Vr = Vl = Vahead
3. Rotate until the robot’s orientation coincides with the target orientation: Vr = – Vl = Vrot

Where, Vrot and Vahead can be chosen arbitrarily.

We can also make the task as a closed loop system with a controller and feedback mechanism. In this method the system will go to the goal location while reducing the error between the present pose and goal pose. Both approaches are implemented and will be discussed in Chapter 4.

## 2.4 DC motor Modeling

[---add content on modeling a DC motor ----]

## 2.5 Odometry

Most robotics problems ultimately reduce to the question: where am I? How can you go somewhere else without some notion of where you are now? You could proceed naively, stumbling around, hoping that your goal will appear in range of your robot’s sensors, but a better plan is to navigate. A basic method of navigation, used by virtually all robots, is odometry, using knowledge of your wheel’s motion to estimate your vehicle’s motion. (A Primer on Odometry and Motion control, Edwin Olson)

In practice there are significant number of ways to implement odometry for robots. We can categorize most of the method into two categories based on the sensor used

1. Using External Sensor : ways of getting information about the position and orientation from outside
  a. Ultrasonic
  b. Infrared
  c. Camera
  d. Lasor scanner
  e. GPS
1. Using Internal Sensor : ways of getting information about the position and orientation by calculating inside the system
  a. Compass ( for heading )
  b. Accelerometers, Gyroscopes ( for position )
  c. Wheel encoder ( both for heading and position )

The robot presented in this thesis will use optical Encoder and wheel encoder for odometry.


- Figure 2:2 a Optical wheel encoder. b Encoding disk (Mordechai Ben-Ari Robotic Motion and Odometry, Fig5.7)

Wheel Encoder

(A Primer on Odometry and Motion control, Edwin Olson) Suppose our robot is at (x, y, θ). Depending on wheel encoder sensor, we get measurements of how much the motors have rotated (in radians).Given the amount of rotation of the motor and the diameter of the wheel, we can compute the actual distance that the wheel has covered. Given the amount of rotation of the motor and the diameter of the wheel, we can compute the actual distance that the wheel has covered.


Figure 2:3 Odometry geometry. Over a small time period, the robot’s motion can be approximated by an arc. The odometry problem is to solve for (x0, y0, θ0) given (x, y, θ) and dbaseline. In the figure, the robot is moving counter-clockwise. A Primer on Odometry and Motion control, Edwin Olson

The initial state (x, y, θ) defines our starting point, with θ representing the vehicle’s heading. After our vehicle has moved by dlef t and dright, we want to compute the new position, (x0, y0, θ0). The center of the robot (the spot immediately between the two wheels that define’s the robot’s location), travels along an arc as well. Remembering that arc length is equal to the radius times the inner angle, the length of this arc is:

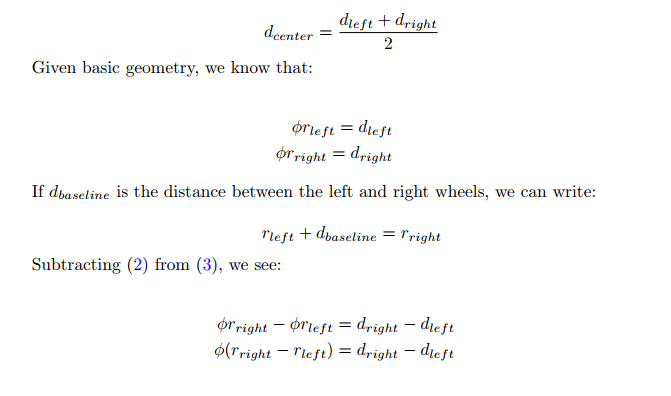
[picture p118: figure]

All of our arcs have a common origin at point P. Note that the angle of the robot’s baseline with respect to the x axis is θ - π/2. We now compute the coordinates of P:

Now we can compute x` and y`

And

If φ is small (as is usually the case for small time steps), we can approximate sin(φ) = φ
and cos(φ) = 1. This now gives us:

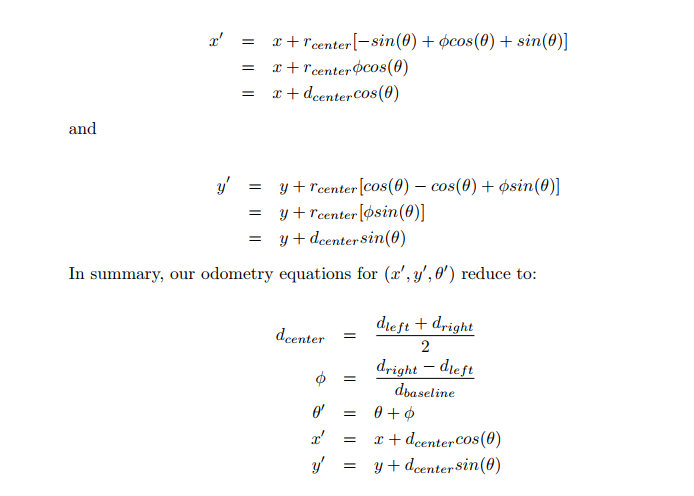
[picture p119: figure]

How do we calculate dr, dl ?

Using wheel encoder sensor mounted behind each wheel. Each wheel encoder is used to count the number of times the motor (left or right) has rotated. This can be used to calculate the distance that the robot has driven or turned.

Δtick = currentTickCount - previousTickCount

D = 2 π R(Δtick /N)

Where R is the radius, N number of opening slots in the encoding disk, and D is either dl or dr with a respective Δtick.

# Chapter 3 Mechanical Structure and Hardware Design

## 3.1 Wheels and Chassis


Figure 3:1 Solid work design exploded view of reclean


Figure 3:2 Solid work design 3D view of RoboClean


Figure 3:3 Solid work design 3D view captured from bottom of RoboClean


Figure 3:4 Solid work design 3D exploded view

The Robot have three wheels in total. Two of the three wheels are on the of center axis of the chassis. The third one will be a caster wheel, which helps for balancing the mass load of the robot. The two-navigation wheel are driven using a DC motor. The DC motor is combined with gears to increase the torque. The specification of the DC motor are as follow: (https://www.wiltronics.com.au/product/10137/yellow-motor-3-12vdc-2-flats-shaft/)

- Operating voltage: 3V - 12V
- Max Torque: 800g/cm @ 3V
- Gear ratio: 1:48
- Load Current; 70mA(250mA max. @3V)
- Stall Current: 500mA max
- Weight: 29g
- Body size: 65mm x 37mm x 22mm (LxWxH)

## 3.2 Cleaning Structure

The robot is designed to be equipped with two rotating sweeper motors, each equipped with two brushes which spin the dirt into the vacuum region. The sweeper motor will be placed slightly away from the center axis. At the center of the robot there will be a vacuum region which will be created by the vacuuming fan motor. Figure 3.6 shows the structure of the dust bin. The dust bin is designed to have a fastest air flow at the bottom opening and has a place to mount fan motor at the top of the structure.


Figure 3:5 Cleaning section of RoboClean


Figure 3:6 Dust bin with a removable plate to remove the dust


Figure 3:7 Bottom view of the dust bin while the removable plate moving

## 3.3 Perception

The robot needs sensors to get at least the gist of what the environment looks like and make its next action. There are various kind of range sensor which can be used for this project. In this project I will use a servo motor and an ultrasonic sensor together to measure the distance as shown on the figure.


Figure 3:8 Distance measurement angle using servo and ultrasonic

The servo moves to the specified angle(10, 45, 90, 135, 170) and the ultrasonic will take the measurement.

Ultrasonic distance measurement module

HC-SR04 module will be used in this project. The following specification are for the module and are from its datasheet.

- Working Voltage DC 5V
- Working Current 15mA
- Working Frequency 40Hz
- Max Range 4m
- Min Range 4cm
- Measuring Angle 15 degree
- Trigger Input Signal 10us TTL pulse
- Echo pin outputs a pulse 150us to 25ms
- Echo pulse will timeout after 38ms of no object detected.
- At 20 degree Celsius the speed of sound is 343m/s

( from Elegoo datasheet for HC-SR04 module)

The time it takes for an HC-SR04 to measure distance:

Time a: time for starting up the trigger

Ta = = 13us

Time b: time for eight burst pulse using 40KHz

Tb=8×(1/40)KHz=0.2ms

Time c: time for the sound signal get back to receiver

Tcn: Tc for 4 cm

Tcn=2×((4cm)/(((34300cm)/s)))=0.23ms

Tcf = Tc for 4 meters

Tcf=2×((4m)/(((343m)/s)))=23.4ms

Total time:

Tmax=13us+0.2ms+23.4ms=23.7ms

Tmin=10us+0.2ms+233us=0.5ms

In one second the ultrasonic sensor can measure a minimum of 1/(23.7ms)=42 measurements.

How long does it take to measure all the five angular position?

The servo motor I am using, SG90, takes 0.12 sec / 60 degrees. Therefore, time it takes one measurement is the sum of time it takes for the servo motor to adjust it position, 0.1 sec, and time it takes for the ultrasonic sensor to measure 5 distinct distances, 5 x 23.7ms = 118ms;

Time for one measurement = 100ms + 118ms = 218ms

This implies in one second we can measure 5 angular positions( 10, 45, 90, 135,170 degree).

## 3.4 Control sensors and microcontroller

Arduino MEGA 2560

- Arduino Mega 2560 is a Microcontroller board based on Atmega2560. It comes with more memory space and I/O pins as compared to other boards available in the market.
- There are 54 digital I/O pins and 16 analog pins incorporated on the board that make this device unique and stand out from others.
- This board comes with two voltage regulators i.e. 5V and 3.3V which provides the flexibility to regulate the voltage as per requirements

(https://www.theengineeringprojects.com/2018/06/introduction-to-arduino-mega-2560.html) Arduino Mega is specially designed for the projects requiring complex circuitry and more memory space. Most of the electronic projects can be done pretty well by other boards available in the market which make Arduino Mega uncommon for regular projects. However, there are some projects that are solely done by Arduino Mega like making of 3D printers or for robotics controlling more than one motors, because of its ability to store more instructions in the code memory and a number of I/O digital and analog pins. Therefore, this project is implemented using Arduino Mega Micro Controller.

Node MCU ESP8622 development board

(https://lastminuteengineers.com/esp8266-nodemcu-arduino-tutorial) The development board equips the ESP-12E module containing ESP8266 chip having Tensilica Xtensa® 32-bit LX106 RISC microprocessor which operates at 80 to 160 MHz adjustable clock frequency and supports RTOS.

(https://lastminuteengineers.com/esp8266-nodemcu-arduino-tutorial)There’s also 128 KB RAM and 4MB of Flash memory (for program and data storage) just enough to cope with the large strings that make up web pages, JSON/XML data, and everything we throw at IoT devices nowadays.

(https://lastminuteengineers.com/esp8266-nodemcu-arduino-tutorial)The ESP8266 Integrates 802.11b/g/n HT40 Wi-Fi transceiver, so it can not only connect to a WiFi network and interact with the Internet, but it can also set up a network of its own, allowing other devices to connect directly to it. This makes the ESP8266 NodeMCU even more versatile.

The feature explained above make Node MCU ESP8266 the perfect choice for controlling the robot from anywhere in this world. In this project the Node MCU ESP8266 works as a soft Access point and hosts a server. [….adddd…]

[schematic while connecting ESP8266 with Arduino mega]

Ultrasonic Sensor

(https://www.fierceelectronics.com/sensors/what-ultrasonic-sensor#:~:text=An%20ultrasonic%20sensor%20is%20an,sound%20that%20humans%20can%20hear).)

An ultrasonic sensor is an electronic device that measures the distance of a target object by emitting ultrasonic sound waves, and converts the reflected sound into an electrical signal. Ultrasonic waves travel faster than the speed of audible sound (i.e. the sound that humans can hear). Ultrasonic sensors have two main components: the transmitter (which emits the sound using piezoelectric crystals) and the receiver (which encounters the sound after it has travelled to and from the target).

In order to calculate the distance between the sensor and the object, the sensor measures the time it takes between the emission of the sound by the transmitter to its contact with the receiver. The formula for this calculation is D = ½ T x C (https://www.arrow.com/en/research-and-events/articles/ultrasonic-sensors-how-they-work-and-how-to-use-them-with-arduino) (where D is the distance, T is the time, and C is the speed of sound ~ 343 meters/second).

Optical Encoder

An incremental optical encoder, F249 Infrared speed sensor, is used for the purpose of measuring the speed and position of the robot. This IR speed module sensor with the comparator LM393, we can calculate the speed of rotation of the wheels of our robot. If we place a ring gear that rotates attached to our wheel. It could also be used as an optical switch.

The basic operation of this sensor is as follows; If anything is passed between the sensor slot, it creates a digital pulse on the D0 pin. This pulse goes from 0V to 5V and is a digital TTL signal. Then with Arduino we can read this pulse.


Figure 3:9 F249 Infrared speed sensor used for measuring speed and position


Figure 3:10 Speed encoder disk

## 3.5 Power source

All needed power to the components is supplied by a rechargeable battery with a rated voltage between 7V and 11V. No component needed power is supplied using the microcontroller. This will help to supply the necessary needed power for the components without putting too much current load the microcontroller.

Table 3.1 Maximum current usage of all the component while power on.

Components | Running time (%) | Number of components | Max Current drawn(mA)
Microcontroller | 100 | 1 | 50
Wheel motor | 100 | 2 | 2*500
Fan motor | 100 | 1 | 250
Sweeper motor | 100 | 2 | 2*250
Servo motor | 100 | 1 | 100
Ultrasonic sensor | 100 | 1 | 20
Total | | | 1920

A power bank is the a readily available power source for driving the motors and Arduino. As we can see from below image, we can use normal USB cable in conjunction with a power bank to power the circuit.


Figure 3:11 Power Bank


Figure 3:12 Inside the USB cable wire

Battery performance:

- Nominal Output current = 2.1A
- Nominal Output Voltage = 5 V
- Nominal Capacity = 10,000mAh.
- Total current consumption is 1920 mA
- Running time of the robot =10,000 mAh/ 1920mA = 5.2hour

## 3.6 Physical Dimension

Table 3.2 Physical dimension of the different parts of the robot

Components | Length(cm) | Width (cm) | height(cm) | Mass(g)
Dustbin | 10 | 10 | 4 | 50
Chassis | 25 | 25 | - | 200
Motor | 1.8 | 7 | 7 | 20*5
Battery | 7 | 14 | 1.5 | 200
breadboard | 5.5 | 16.5 | 1 | 80
Arduino | 6 | 11 | 1.5 | 40
Additional body part | - | - | - | 200
Total | | | | ~900

## 3.7 Feasibility analysis

Power: considering the maximum total current( 1920mA ) that may be required by the robot, power source must deliver the required amount of current. The testing power bank has the capacity of 2.1A output current, which is enough to run the robot even at its peak power needed.

Torque: From the specification we can see that the starting torque of the motor is 800 g*cm. The robot is driven using two motor. Two motor, each having 800 g*cm torque, are expected to carry the whole mass around. The expected mass is calculated in the physical dimension table. The whole expected mass is around 900gram.

## 3.8 Schematic Diagram

[-----adddd schematic and circuit diagram here ----]

Figure 3:13 Schematic Diagram for the circuit design

# Chapter 4 Control System Design

## 4.1 Sampling time

There are some distinct tasks performed by the microcontroller. Driving the robot to the goal location, updating position and orientation state, sensing the environment for any obstacle, and checking for conditions to switch from one mode of operation to another. All these tasks have a clear priority from one another. For example, updating the pose state has a highest priority. This task should be implemented within a very small time period. Next to updating pose task, sensing the environment for an obstacle take the second priority over the rest of the tasks.

Since Arduino Mega has a limited processing speed of 16MHz, tasks should be given a different priority level from one another. This can be achieved by allocating a different minimum amount of time period at which the tasks must be performed.

1. Updating position and orientation ----- 100ms
2. Sensing the environment ----- 150ms
3. Checking condition to switch from one behavior to another ----- 500ms

There is one other task which need an absolute high priority, which is processing signals generated from the wheel encoder. This task will be implemented using interrupt.

## 4.2 Design Architecture

As discussed in Chapter two the robot is model as differential drive with the equation as shown below:

x`=((Vr+Vl)/2)cosϕ

y`=((Vr+Vl)/2)sinϕ

ϕ`=(Vr-Vl)/L

These equation shows that the input for the system are Vr and Vl. Controlling a robot by changing Vr and Vl seems counterintuitive therefore we will add another level of abstraction to our design. The new design method is to model the robot as a Unicycle and finally make a map between the new design method and the real implementation model design.

### 4.2.1 The Unicycle Model


Figure 4:1 Example of a unicycle drive


Figure 4:2 The Simplified Unicycle Robot Model

Inputs: Velocity (V) and angular velocity (w)

Dynamics x`=Vcosϕ

y`=Vsinϕ

ϕ`=ω

This way we can control the robot using transitional velocity and angular velocity if and only if we make a conversion from (V, w) ----→ ( Vl, Vr).

Design Model Implementation model

x`=Vcosϕ x`=((Vr+Vl)/2)cosϕ

y`=Vsinϕ y`=((Vr+Vl)/2)sinϕ

ϕ`=ω ϕ`=(Vr-Vl)/L

Using these two sets of equation we can get the relation from (V, w) to ( Vl, Vr).

Vr=(2V+ ωL)/2

Vl=(2V- ωL)/2

The above result implies we can have to models, one for design and the other for implementation and we can relate their input as shown on the above equations.

### 4.2.2 High level model

Controlling the robot using translational velocity and angular velocity makes a huge simplification from the implementation model, differential drive model. There are still questions that this model could not answer easily. For example, how could we determine the speed of the robot with respect to the goal location? Is this model helpful to design various behavior easily?

The above questions are not simply answered by the unicycle model alone. It would be very useful if we add an additional abstraction layer. I call this a high-level model.


Figure 4:3 A robot and the control vector

Dynamics

x`=u, x∊ R² u = [ux, uy]

This equation should be mapped to unicycle model of the robot. Fortunately, these two equations are mapped easily as shown below.

ϕ_d =atan⁡((u_y)/(u_x))

V= √(u_y +u_x)

ω=PID(e)=K_p e+ K_i ∫_0^τ e(t)dτ+(K_d e(t))/(dt) e= ϕ_d - ϕ

## 4.3 Go-to-Goal behavior

This is one of the most necessary behavior for a robot is to move from current location to a goal location, go-to-goal behavior.

e=x_g -x

u=ke

x`=u

e`=0-x`

e`= -ke

A linear controller means the robot goes faster when it is further away from the goal. If we make the gain k a function of e, we can limit the amount of speed.


k=(v_o |1-e^(-α||e||^2) |)/(||e||)

## 4.4 Obstacle avoidance


The error dynamics shows that the error is unstable and the robot will drive off to infinity. A simple solution is to switch to another behavior when the distance is greater than a given value.

# Chapter 5 Testing and Simulation Result

## 5.1 Result

## 5.2 Conclusion

This paper highlights a better and simpler approach in providing an overview of the design of an autonomous vacuum cleaner robot. This robot is designed to have all the features of a
conventional vacuum cleaner. It can work automatically and manually. The robot can be made useful in large areas of coverage such as hospitals, industries, schools, etc. It can also be
used where cleaning involving humans may be harmful.

# Chapter 6 Reference

Asafa, T. B., T. M. Afonja, E. A. Olaniyan, and H. O. Alade. 2018. “Development of a Vacuum Cleaner Robot.” Alexandria Engineering Journal 57(4).
