MrEngineerET/roboClean/Code/Matlab/goToGoaltheta.jpg

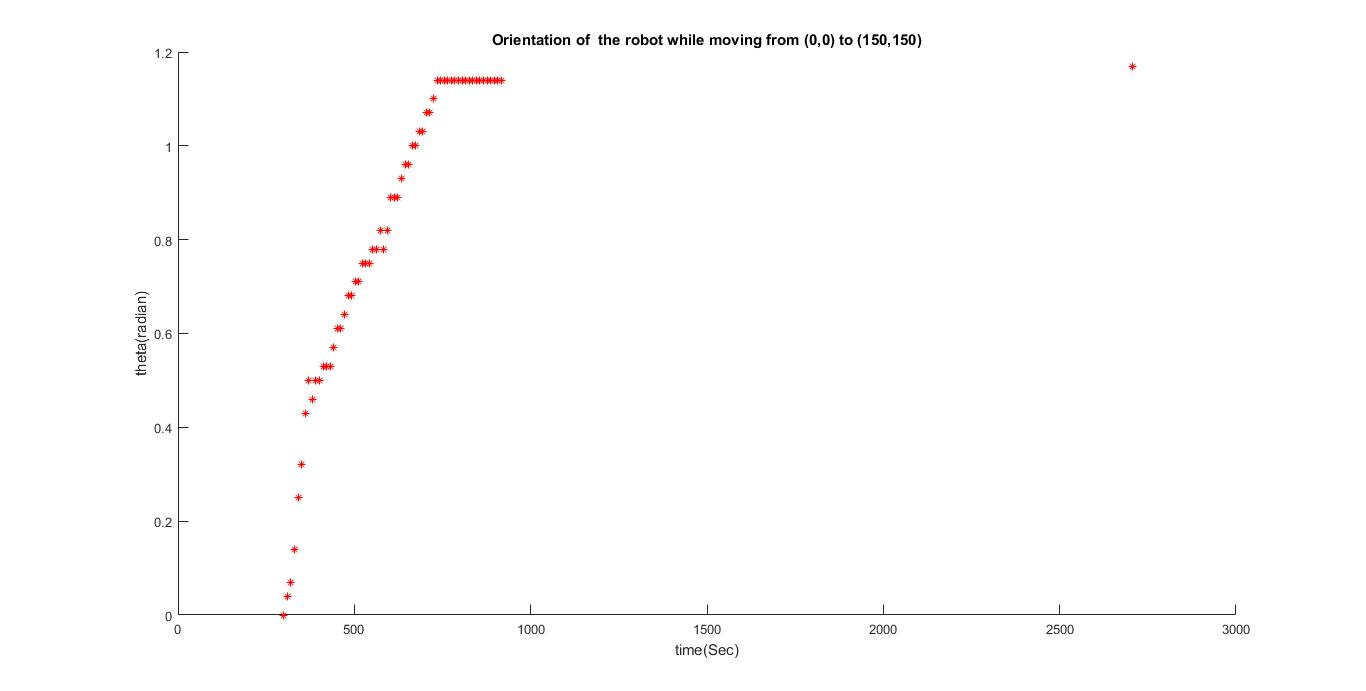
Code/Matlab/goToGoaltheta.jpg
