MrEngineerET/roboClean/Documentation/Images/controller.png

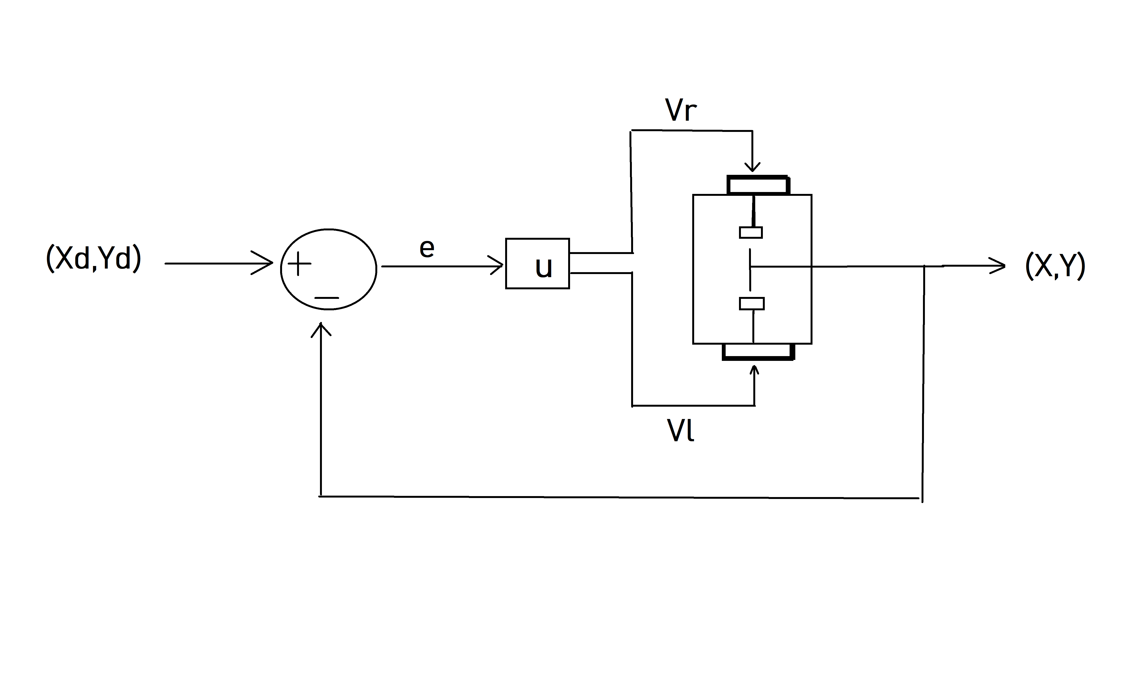
Documentation/Images/controller.png
