MrEngineerET/roboClean/Documentation/Images/differentialDrive with ultrasonic.png

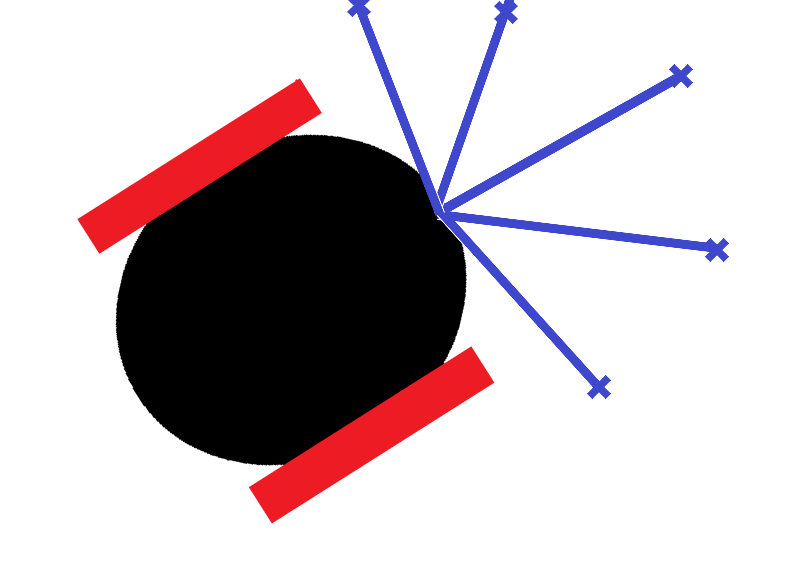
Documentation/Images/differentialDrive with ultrasonic.png
