MrEngineerET/roboClean/Documentation/Images/differentialDrive.png

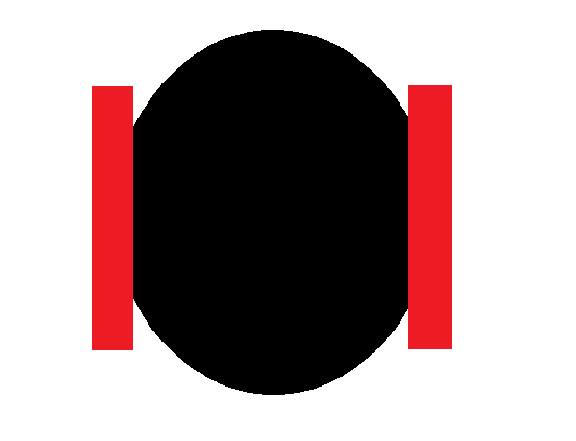
Documentation/Images/differentialDrive.png
