MrEngineerET/roboClean/Documentation/Images/goal location.png

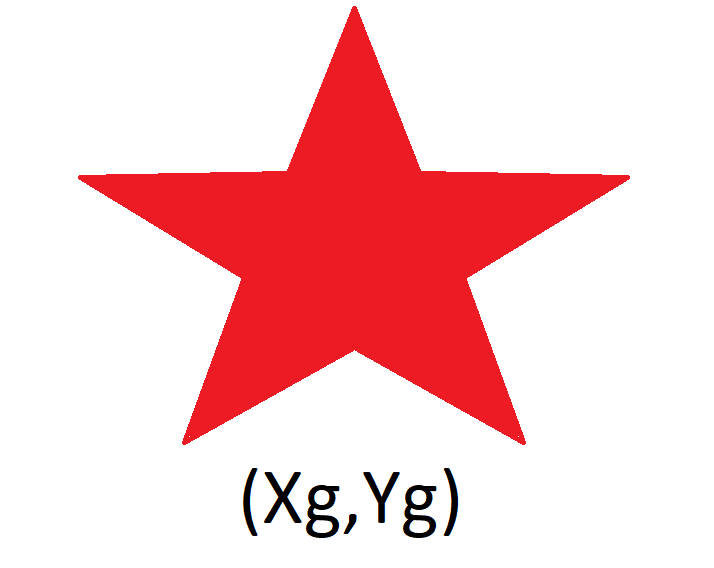
Documentation/Images/goal location.png
