MrEngineerET/roboClean/Documentation/Images/Progress/Final Hardware/DSC_0024.JPG

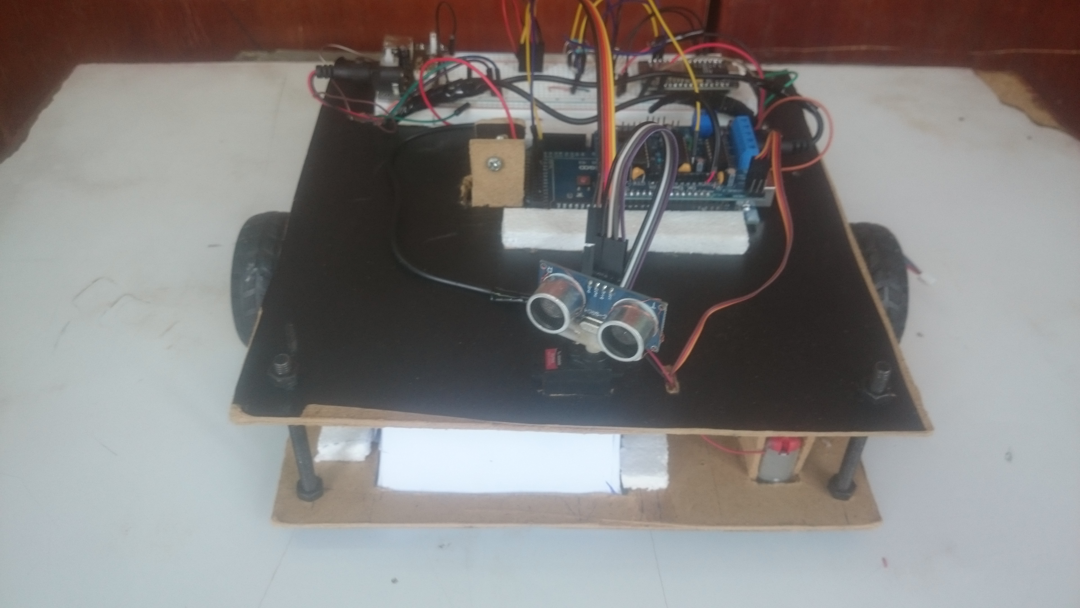
Documentation/Images/Progress/Final Hardware/DSC_0024.JPG
