MrEngineerET/roboClean/Documentation/Images/Progress/Final Hardware/DSC_0026.JPG

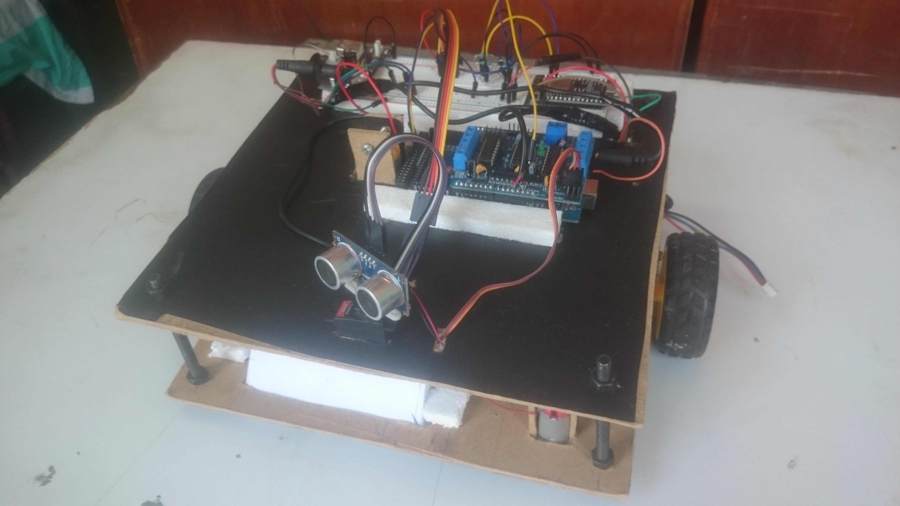
Documentation/Images/Progress/Final Hardware/DSC_0026.JPG
