MrEngineerET/roboClean/Documentation/Images/Progress/Final Hardware/DSC_0027.JPG

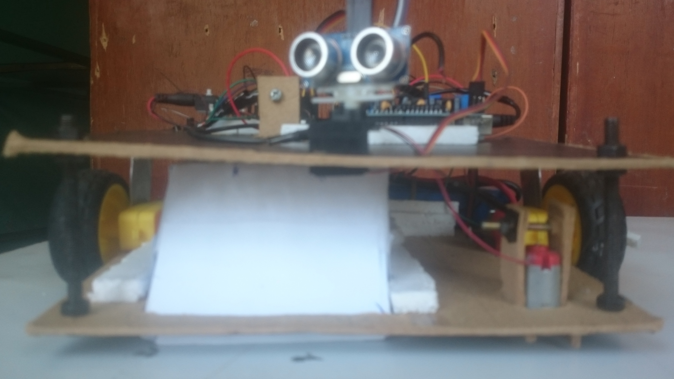
Documentation/Images/Progress/Final Hardware/DSC_0027.JPG
