MrEngineerET/roboClean/Documentation/Images/Progress/Final Hardware/DSC_0029.JPG

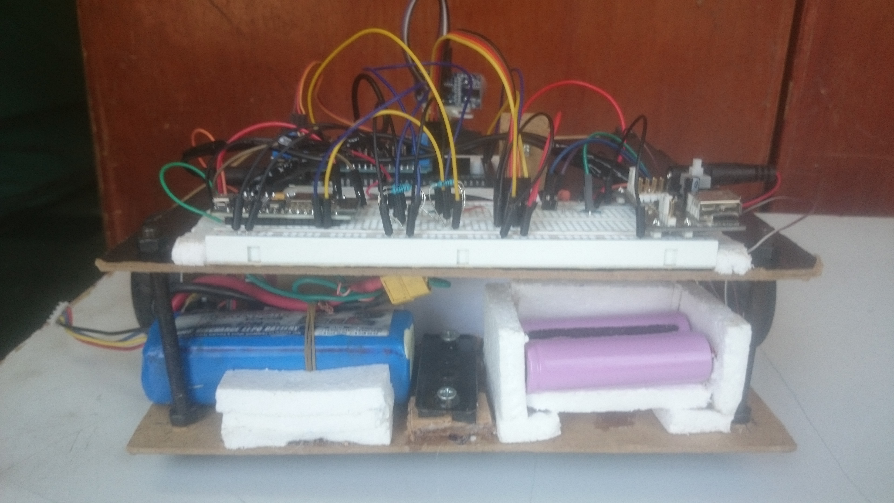
Documentation/Images/Progress/Final Hardware/DSC_0029.JPG
