MrEngineerET/roboClean/Documentation/Images/Progress/Hardware/phase one/20201018_231808.jpg

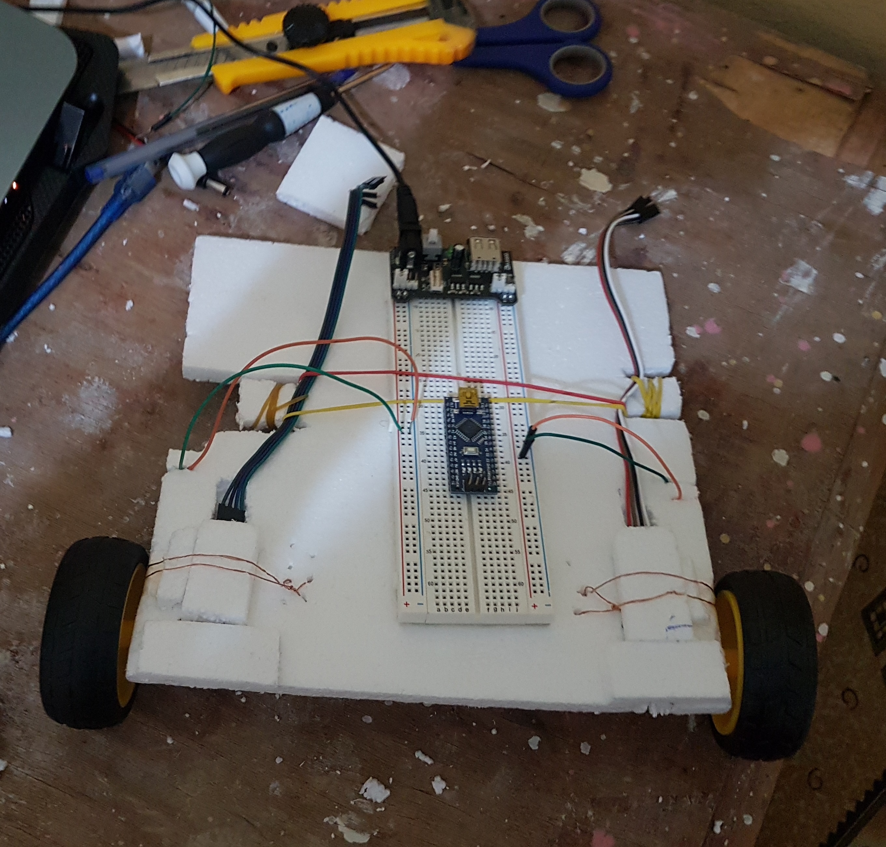
Documentation/Images/Progress/Hardware/phase one/20201018_231808.jpg
