MrEngineerET/roboClean/Documentation/Images/Progress/Hardware/phase one/20201027_151348.jpg

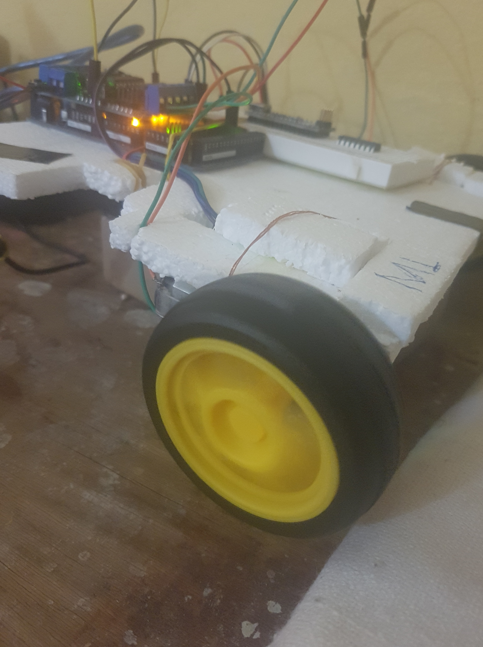
Documentation/Images/Progress/Hardware/phase one/20201027_151348.jpg
