MrEngineerET/roboClean/Documentation/Images/Progress/Hardware/phase one/BeFunky-collage.jpg

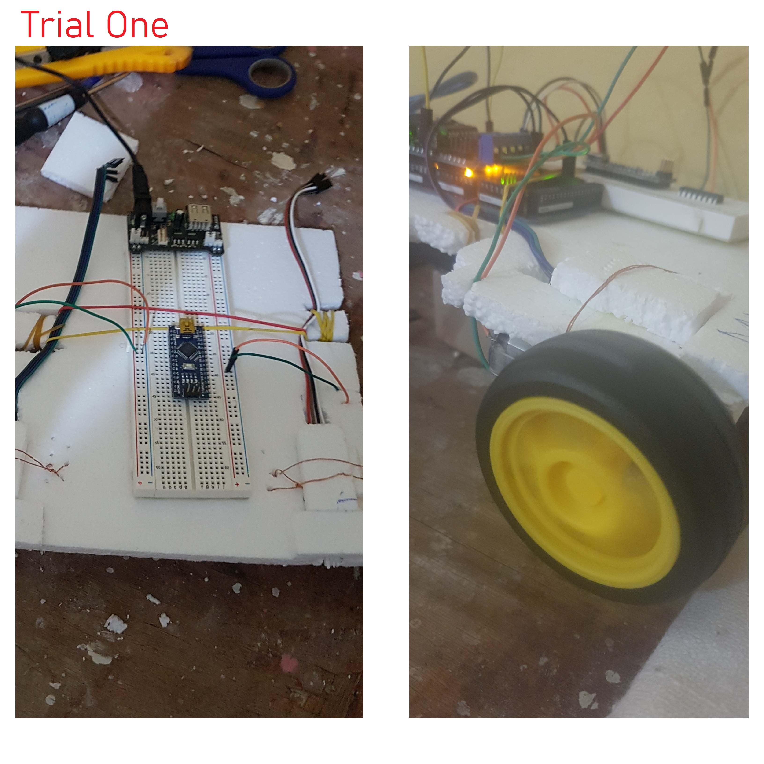
Documentation/Images/Progress/Hardware/phase one/BeFunky-collage.jpg
