MrEngineerET/roboClean/Documentation/Images/Progress/Hardware/phase three/collage.png

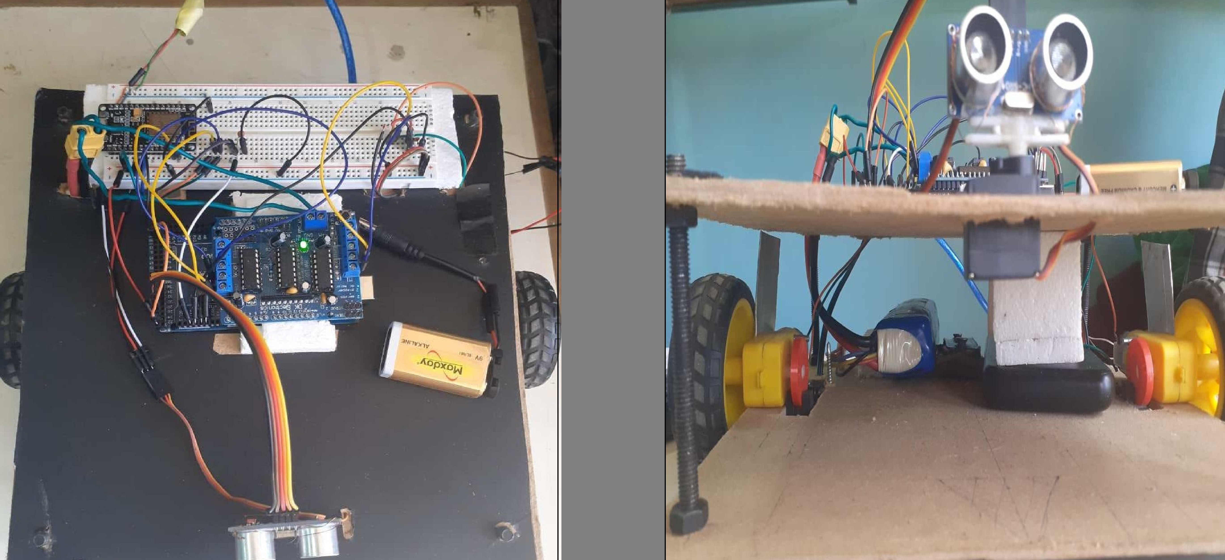
Documentation/Images/Progress/Hardware/phase three/collage.png
