MrEngineerET/roboClean/Documentation/Images/Progress/Hardware/phase three/photo_2020-12-10_14-23-00.jpg

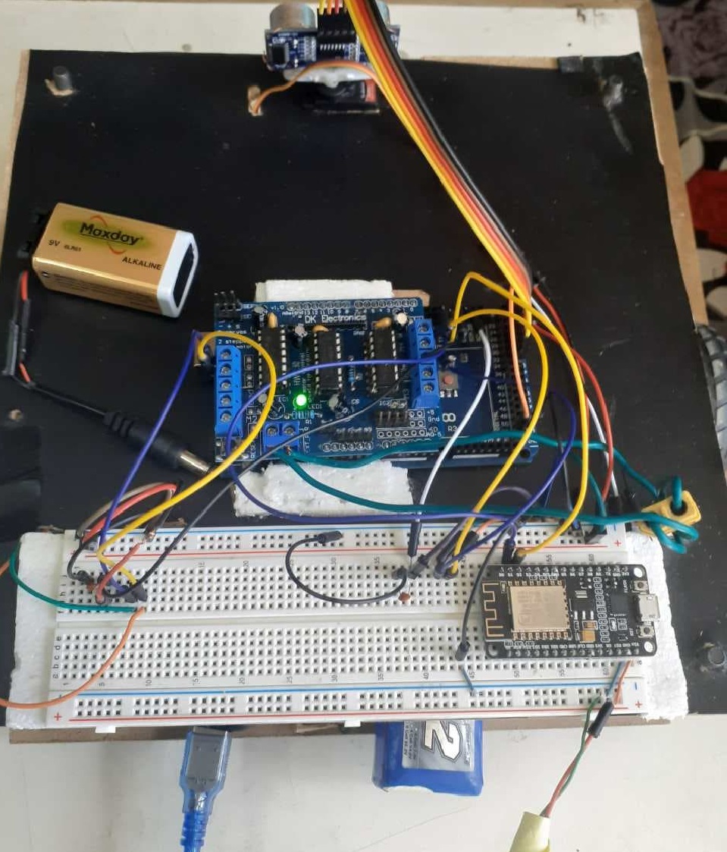
Documentation/Images/Progress/Hardware/phase three/photo_2020-12-10_14-23-00.jpg
