MrEngineerET/roboClean/Documentation/Images/Progress/Hardware/phase two/20201029_235510.jpg

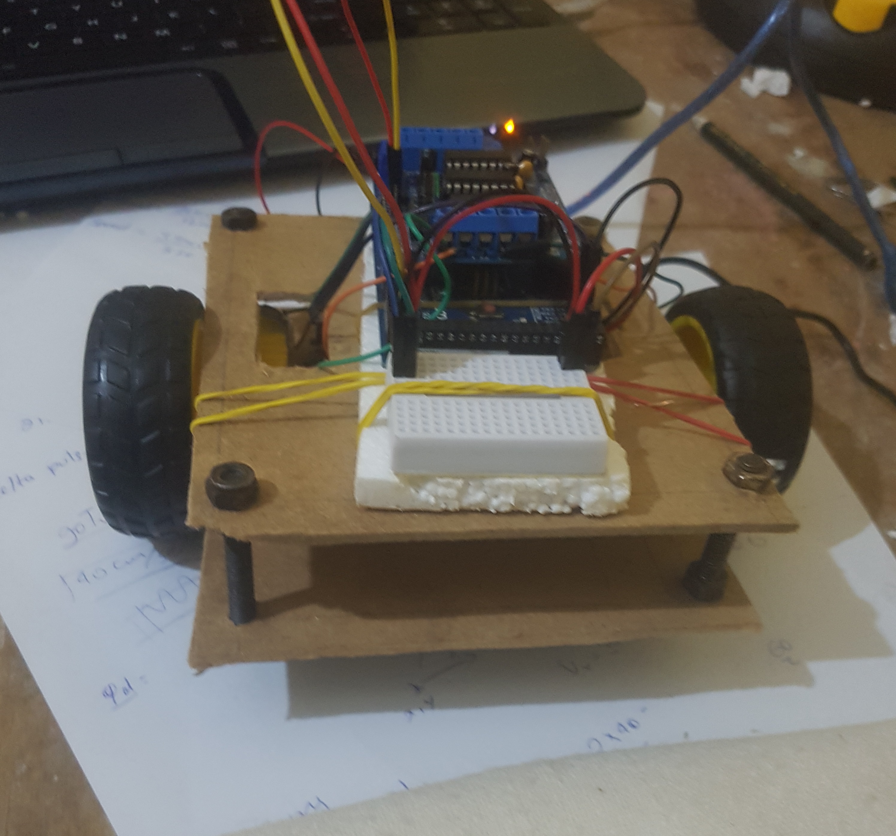
Documentation/Images/Progress/Hardware/phase two/20201029_235510.jpg
