MrEngineerET/roboClean/Documentation/Images/Progress/Hardware/phase two/20201029_235529.jpg

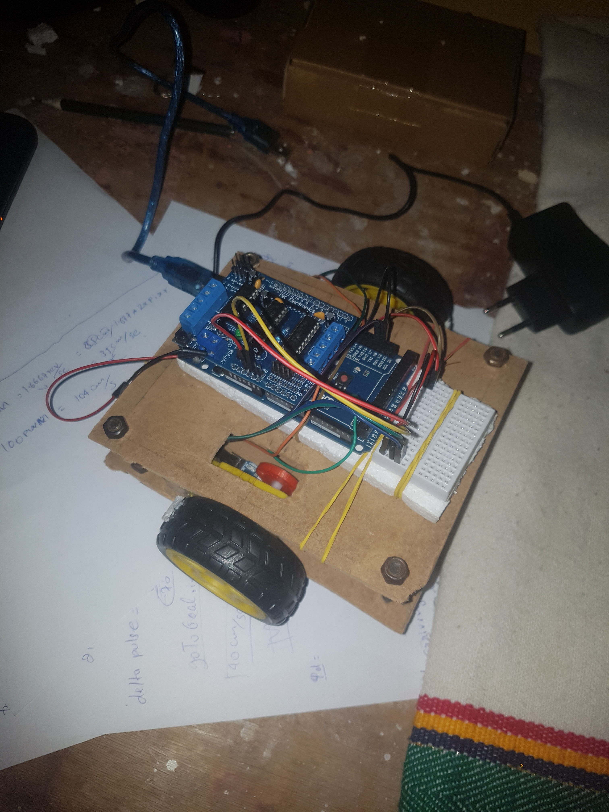
Documentation/Images/Progress/Hardware/phase two/20201029_235529.jpg
