MrEngineerET/roboClean/Documentation/Images/Progress/Phase one/20201018_231757.jpg

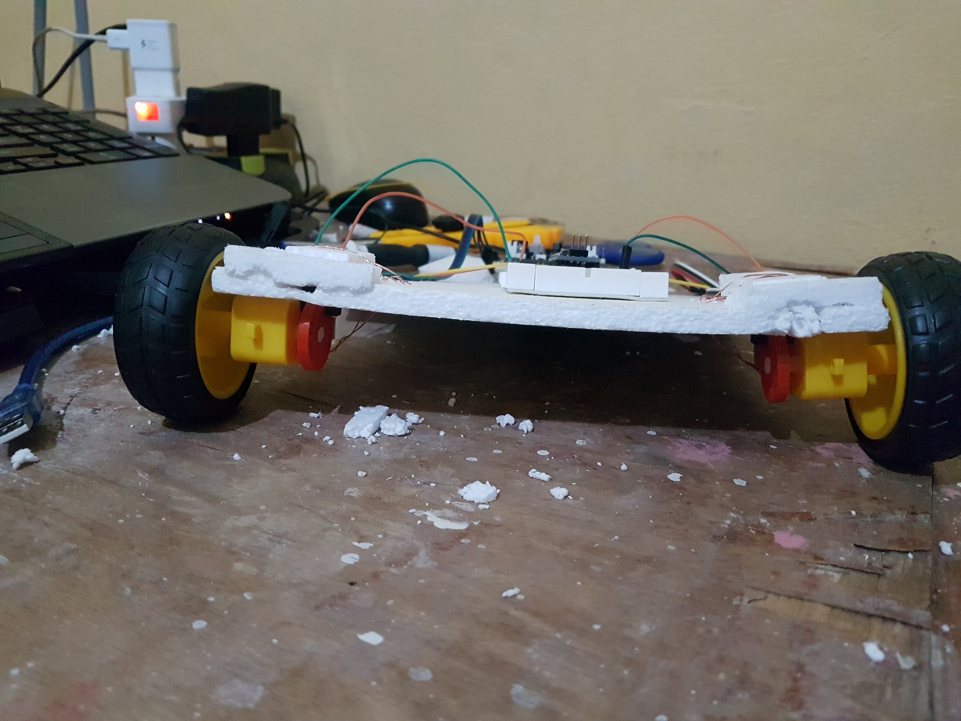
Documentation/Images/Progress/Phase one/20201018_231757.jpg
