MrEngineerET/roboClean/Documentation/Images/Progress/Phase one/20201018_231800.jpg

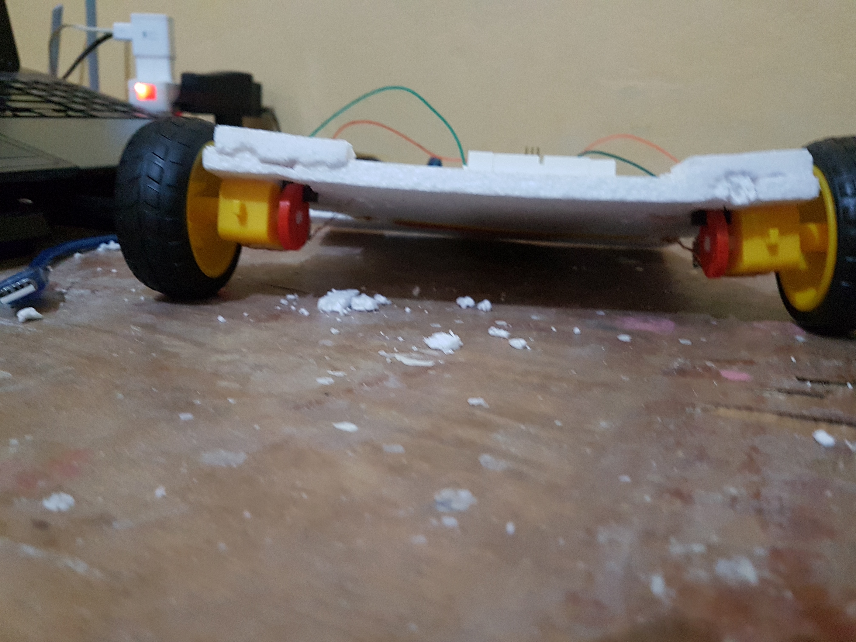
Documentation/Images/Progress/Phase one/20201018_231800.jpg
