MrEngineerET/roboClean/Documentation/Images/robotOnWorldFrame.png

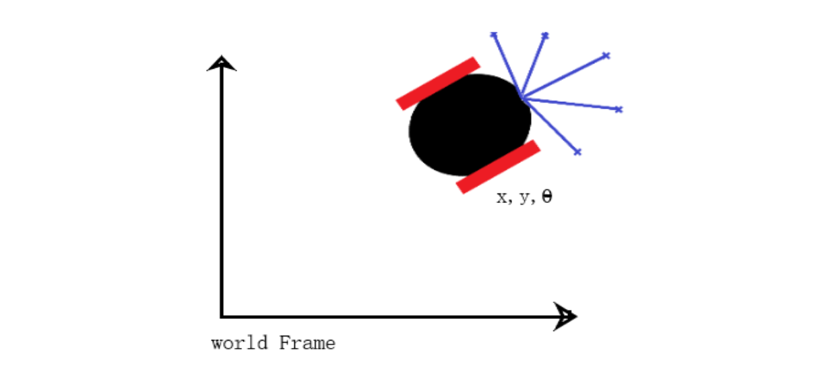
Documentation/Images/robotOnWorldFrame.png
