MrEngineerET/roboClean/Documentation/Images/sensorsOnRobtFrame.png

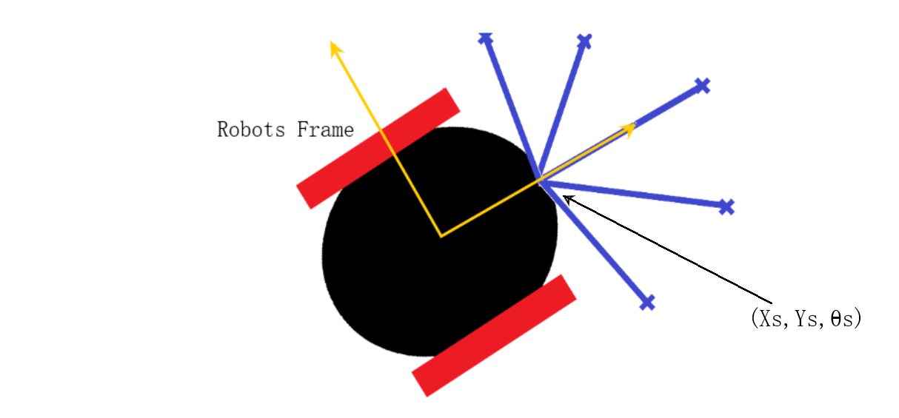
Documentation/Images/sensorsOnRobtFrame.png
