MrEngineerET/roboClean/Documentation/Images/Untitled.png

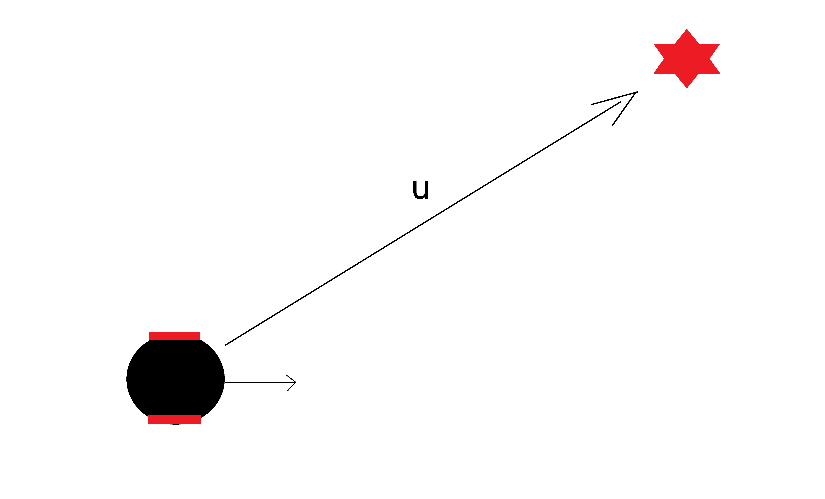
Documentation/Images/Untitled.png
