MrEngineerET/roboClean/Simulation/SolidWork/Cleaning Structure/Biruk dust bin.SLDASM

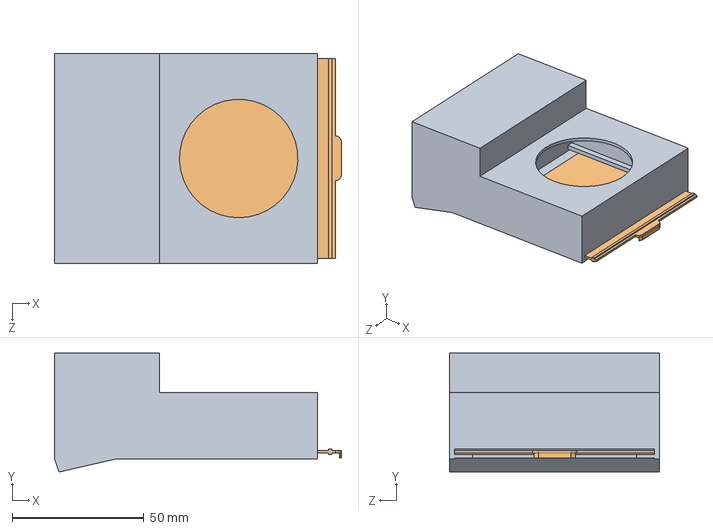
[picture p158: CAD file, 2020-12-03]
Simulation/SolidWork/Cleaning Structure/Biruk dust bin.SLDASM
109.1 x 45.2 x 80.0 mm
vacume
draw
