MrEngineerET/roboClean/Simulation/SolidWork/Cleaning Structure/draw.SLDPRT

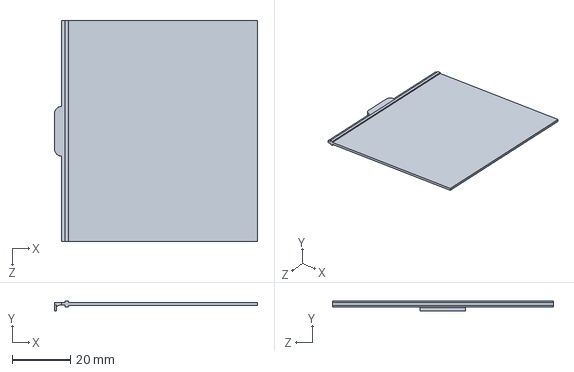
[picture p159: CAD file, 2020-12-03]
Simulation/SolidWork/Cleaning Structure/draw.SLDPRT
69.8 x 3.47 x 76.0 mm
