MrEngineerET/roboClean/Simulation/SolidWork/Cleaning Structure/vacume.SLDPRT

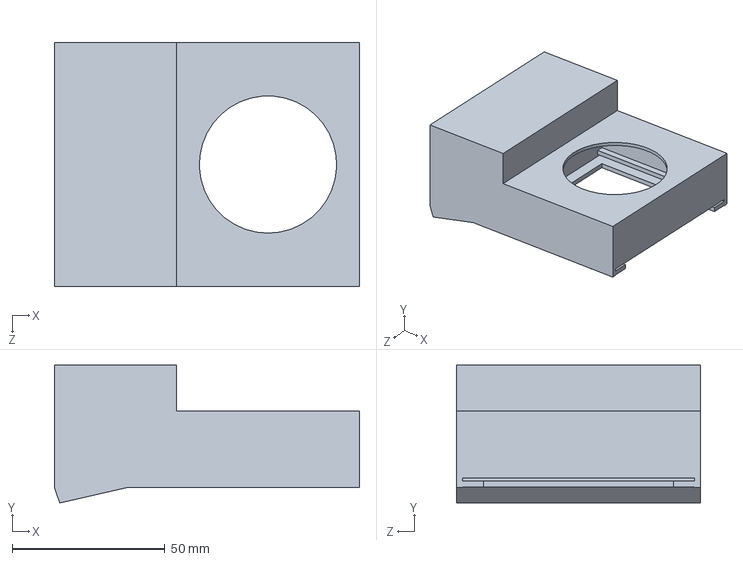
[picture p160: CAD file, 2020-12-03]
Simulation/SolidWork/Cleaning Structure/vacume.SLDPRT
100.0 x 45.2 x 80.0 mm
