MrEngineerET/roboClean/Code/Arduino/WIRELESS MODE/goToGoalWireless/goToGoalWireless.ino

// this test program print the velocity and angular velocity of the robot
// median filter for the calculation of velocities is applied

#include <math.h> // required to use atan () function
#define PI 3.1415926535897932384626433832795 // PI number definition
#include <AFMotor.h>

// MOTOR VARIABLES
#define LEFT_WHEEL 1
#define RIGHT_WHEEL 2
#define switchPin 31

//LEFT WHEEL VARIABLES
int leftEncoderPin = 18; // Pin 18, where the left encoder pin DO is connected
volatile unsigned long currentLeftEncoderPulses = 0;   // Number of left Encoder pulses
volatile unsigned long previousLeftEncoderPulses = 0;   // Number of left Encoder pulses
int leftMotorSpeed = 0;   // speed value for leftMotor which is between 0 and 255
AF_DCMotor leftWheel(1); // Motor 3 section of the motor shield will be used for left Motor of the robot

//RIGHT WHEEL VARIABLES
int rightEncoderPin = 19; // Pin 19, where the right ecoder pin DO is connected
volatile unsigned long currentRightEncoderPulses = 0;  // Number of right Encoder pulses
volatile unsigned long previousRightEncoderPulses = 0;  // Number of right Encoder pulses
int rightMotorSpeed = 0;    // speed value for rightMotor which is between 0 and 255
AF_DCMotor rightWheel(3); // Motor 4 section of the motor shield will be used for right Motor of the robot

// variable used for reading a clean and good signal from the encoder
volatile unsigned long debounceL = 0;   // time stamp of the last bounce of the incoming signal from the left encoder
volatile unsigned long debounceR = 0;   // time stamp of the last bounce of the incoming signal from the right encoder

// DESIGN VARIABLE
const int delta = 100;    // sampling time of the system
unsigned long currentTimeSample = 0;
unsigned long previousTimeSample = 0; 

// variables used for finding time difference between two instant time
unsigned long currentErrorPIDTimeSample = 0;
unsigned long previousErrorPIDTimeSample = 0;

unsigned long currentErrorSumTimeSample = 0;
unsigned long previousErrorSumTimeSample = 0;

// ODOMETRY VARIABLES
#define ARRAYSIZE 4
const byte numberOfHole = 20; // number of holes on the motor encoder disk
const float diameter = 6.8; // the radius of left and right wheels[cm]
float Dl = 0; // the latest value of distance moved by the left wheel
float arrDl[ARRAYSIZE]; // array for holding the latest distance moved by the left wheel(Dl) and some other past values
float meanDl = 0; // the mean value of the Dl array
float Dr = 0; // the latest value of distance moved by the right wheel
float arrDr[ARRAYSIZE]; // array for holding the latest distance moved by the right wheel(Dl) and some other past values
float meanDr = 0; // the mean value of the Dr array
float Dc = 0;
float x = 0;  // the x position of the robot
float y = 0;  // the y postition of the robot
float phi = 0; // the orientation of the robot
const float L = 30; // length of the robot between tires[cm]

// ROBOT INPUT VARIABLE
float V = 0;  // the overall velocity of the robot [cm/sec]
float Vr = 0; // the velocity of the right wheel
float Vl = 0; // the velocity of the left wheel
float W = 0;  // the angular velocity og the robot

// ROBOT INPUT VARIABLE CONTROLLED BY PID (GO TO GOAL)
float Xg; // the x axis goal position of the robot
float Yg; // the y axis goal position of the robot
float phid = 0; 
float phiErr = 0;
float phiErrOld = 0;
float phiErrSum = 0;
float Kp = 20;
float Ki = 10;
float Kd = 5;
// VALUES FOUND BY EMPIRICAL EXPERMENT
const int PWMmax = 140;
const int PWMmin = 110;
const int Vmax = 90;  // [cm/s]

const int Wmax_V0 = 50;  // [cm/s]
const int Vmax_W0 = 90;  // [cm/s]
const int robotMaxSpeed = 90;  // [cm/s]
const int robotMinSpeed = 35; // [cm/s]

void setup () {
   attachInterrupt (digitalPinToInterrupt(leftEncoderPin), LEncoder, RISING); // interrupt function: interrupt pin, function to call, type of activation
   attachInterrupt (digitalPinToInterrupt(rightEncoderPin), REncoder, RISING); // interrupt function: interrupt pin, function to call, type of activation
   Serial.begin(9600); // start of serial communication
   Serial2.begin(9600);
   moveMotor(LEFT_WHEEL,FORWARD,0);
   moveMotor(RIGHT_WHEEL,FORWARD,0);
   pinMode(switchPin,INPUT_PULLUP);
   initialize();
   delay(3000);
}

void loop () {
  if(digitalRead(switchPin) == 1){
      moveMotor(LEFT_WHEEL,FORWARD,0);
      moveMotor(RIGHT_WHEEL,FORWARD,0);
      initialize();
      delay(3000);
   }else{
    currentTimeSample = millis();
    if(currentTimeSample - previousTimeSample > delta){
       previousTimeSample = currentTimeSample;
      
       odometry();
      
       goToGoal();
//  
      Serial2.print(x); 
      Serial2.print(",");
      Serial2.print(y);
      Serial2.print(","); 
      // time is sent in milli second
      Serial2.print((float)millis());
      Serial2.print(",");
      Serial2.println(phi); 

//        Serial2.println("message from go to goal wireless");

//      Serial.print(x); 
//      Serial.print(",");
//      Serial.print(y);
//      Serial.print(","); 
//      Serial.print((float)millis()/1000);
//      Serial.print(",");
//      Serial.println(phi); 

  //        Serial.print(phid); 
  //        Serial.print(", ");
  //        Serial.print(phiErr); 
  //        Serial.print(", ");
  //        Serial.print(W); 
  //        Serial.print(", ");
//          Serial.print(Vl); 
//          Serial.print(", ");
//          Serial.print(Vr); 
//          Serial.print(", ");        
//          Serial.print(leftMotorSpeed); 
//          Serial.print(", ");
//          Serial.println(rightMotorSpeed);
  //        Serial.print(", ");        
  //        Serial.print(x); 
  //        Serial.print(", ");
  //        Serial.println(y);
          
        // for observing the angular velocity of the robot
        // Serial.println(W);
      }
   }
}

void initialize(){
   Xg = 150;  
   Yg = 50;
   V = 50;
   x = 0; 
   y = 50;
   phi = 0;
   phid = 0; 
   phiErr = 0;
   phiErrOld = 0;
   phiErrSum = 0; 
   Vr = 0; 
   Vl = 0;
   W = 0; 
   currentTimeSample = 0;
   previousTimeSample = 0; 
}

void LEncoder () {// interrupt function of the left wheel encoder
    if(digitalRead(leftEncoderPin) && (micros()- debounceL > 100) && digitalRead(leftEncoderPin)){
        currentLeftEncoderPulses++;
        debounceL = micros();
    }
}
void REncoder () {// interrupt function of the right wheel encoder
   if(digitalRead(rightEncoderPin) && (micros()- debounceR > 100) && digitalRead(rightEncoderPin)){
        currentRightEncoderPulses++;
        debounceR = micros();
    }
}

void moveMotor(int WHEEL,int DIRECTION, int mSpeed){
  if(WHEEL == LEFT_WHEEL){
      if(DIRECTION == FORWARD){
        leftWheel.run(FORWARD);
        leftWheel.setSpeed(mSpeed);
      }else{
        leftWheel.run(BACKWARD);
        leftWheel.setSpeed(mSpeed);
      }
  }else if(WHEEL == RIGHT_WHEEL){
      if(DIRECTION == FORWARD){
        rightWheel.run(FORWARD);
        if(mSpeed == 0){
          rightWheel.setSpeed(mSpeed);
        }else {
          rightWheel.setSpeed(mSpeed+30);
        }
      }else{
        rightWheel.run(BACKWARD);
        if(mSpeed == 0){
          rightWheel.setSpeed(mSpeed);  
        }else{
          rightWheel.setSpeed(mSpeed+30);        
        }
      }
  }
}

void odometry(){
  // median filter
  Dl = ((float)(currentLeftEncoderPulses-previousLeftEncoderPulses)/numberOfHole) * PI * diameter;
  previousLeftEncoderPulses = currentLeftEncoderPulses;
  Dr = ((float)(currentRightEncoderPulses-previousRightEncoderPulses)/numberOfHole) * PI * diameter;
  previousRightEncoderPulses = currentRightEncoderPulses;
  byte i = 0;
  for( i; i < ARRAYSIZE - 1; i++){
    arrDl[i] = arrDl[i+1];
    arrDr[i] = arrDr[i+1];
  } 
  arrDl[i] = Dl;
  arrDr[i] = Dr;
  i = 0;
  for( i; i < ARRAYSIZE ; i++){
    meanDl += arrDl[i];
    meanDr += arrDr[i];
  } 
  meanDl /= ARRAYSIZE;
  meanDr /= ARRAYSIZE;
  
  Dc = ((float)Dl+Dr)/2;
  x = x + Dc*cos(phi);
  y = y + Dc*sin(phi);
  phi = phi + (Dr - Dl)/L;
  phi = atan2(sin(phi),cos(phi));
}

void avoidObstacle(){
  
}

void goToGoal(){
   if(abs(Xg - x) < 10 && abs(Yg - y) < 10){
      moveMotor(LEFT_WHEEL,FORWARD,0);
      moveMotor(RIGHT_WHEEL,FORWARD,0);
      return;
   }
  phid = atan2(Yg-y,Xg-x);
  phiErr = phid - phi;
  currentErrorSumTimeSample = millis();
  phiErrSum += phiErr * (currentErrorSumTimeSample-previousErrorSumTimeSample)/1000;
  previousErrorSumTimeSample = currentErrorSumTimeSample;
  if(phiErr < PI/8 && phiErr > -PI/8){
    smallPhiErrorController();
  }else{
    largePhiErrorController();
  }
}
float smallPhiErrorController(){ // for phiError < pi/8 or phiError > -phi/8
// PID controller for angular velocity of the robot
  currentErrorPIDTimeSample = millis();
//  W = Kp * phiErr;
  W = Kp * phiErr + Ki*phiErrSum + Kd*((phiErr-phiErrOld)/(currentErrorPIDTimeSample-previousErrorPIDTimeSample));
  previousErrorPIDTimeSample = currentErrorPIDTimeSample;
  phiErrOld = phiErr;
  // validate if the angular velocity is ensured
  ensure_W();

  leftMotorSpeed = map(Vl,robotMinSpeed,robotMaxSpeed,PWMmin,PWMmax);
  rightMotorSpeed = map(Vr,robotMinSpeed,robotMaxSpeed,PWMmin,PWMmax);
  moveMotor(LEFT_WHEEL,FORWARD,leftMotorSpeed);
  moveMotor(RIGHT_WHEEL,FORWARD,rightMotorSpeed);
   V = 60;  
}

float largePhiErrorController(){ // for phiError > pi/8 or phiError < -phi/8
  if(phiErr >= PI/8){
    // move the robot in counter clockwise  
     moveMotor(LEFT_WHEEL,FORWARD,0);
     moveMotor(RIGHT_WHEEL,FORWARD,PWMmax+10);
  }else if(phiErr <=-PI/8){
    // move the robot in clockwise
     moveMotor(LEFT_WHEEL,FORWARD,PWMmax+10);
     moveMotor(RIGHT_WHEEL,FORWARD,0);
  }
    phiErrSum = 0;
    phiErrOld = 0;
}

void ensure_W(){
  // This function ensures that w is respected as best as possible
  // by sacrificing v. 
            
  // 1. Limit v,w from controller to +/- of their max
  V = max(min(V ,Vmax_W0), -Vmax_W0);
  W = max(min(W, Wmax_V0), -Wmax_V0);
   // unicycle( v,w) to differential (Vl,Vr)
  float Vl_d = (2*V - W*L)/diameter;
  float Vr_d = (2*V + W*L)/diameter;
  //  Find the max and min 
  float V_rl_max = max(Vr_d, Vl_d);
  float V_rl_min = min(Vr_d, Vl_d); 
  
  //  Shift vel_r and vel_l if they exceed max/min vel
  if(V_rl_max > Vmax){
    Vl = Vl_d - (V_rl_max - Vmax);
    Vr = Vr_d - (V_rl_max - Vmax);
  }else if(V_rl_min < -Vmax){
    Vl = Vl_d - (V_rl_min + Vmax);  
    Vr = Vr_d - (V_rl_min + Vmax);
  }else {
    Vl = Vl_d;
    Vr = Vr_d;  
  }
}
