MrEngineerET/roboClean/Code/Node MCU ESP8266/Arduino and ESP Serial Communication/arduino2esp/arduino2esp.ino

void setup() {
  // put your setup code here, to run once:
  Serial.begin(9600);
  Serial2.begin(9600);
  delay(2000);
  Serial.println("Message is about to send to Node MCU");
}

void loop() {
  Serial2.println("message from arduino");
  if(Serial2.available()>0){
    Serial.println(Serial2.readString());
    }
}
