MrEngineerET/roboClean/Simulation/Processing/processingTutorial/robotMotionSimulationv1/robotMotionSimulationv1.pde

import processing.serial.*;
Serial roboCleanSerial;

Robot myRobot;
Tracing traceRobot;
int backgroundColor = 200;
String serialMessage = "";
float messageArray[];
void setup(){
  size(200,200);
  roboCleanSerial = new Serial(this,"COM9",9600);
  roboCleanSerial.clear();
  myRobot = new Robot(0,0,50);
  traceRobot = new Tracing(myRobot.getX(),myRobot.getY());
  background(backgroundColor);
}

void draw(){
  // parse for x value and y value from the serial input 
  if (roboCleanSerial.available()>0){
    serialMessage = roboCleanSerial.readStringUntil('\n');
    if(serialMessage != null) {
      messageArray = splitMessage(serialMessage,',');
    }
    if(!(messageArray.length == 1 && messageArray[0] == -1)){
      float x = messageArray[0];
      float y = messageArray[1];
      myRobot.move(x,y);
      traceRobot.drawTrace(myRobot.getX(),myRobot.getY());  
    }
  }
  
  image(myRobot.graphics(),0,0);
  image(traceRobot.graphics(),0,0);
}

class Robot{
  float x; // the x axis positon for the center of the robot
  float y; // the y axis position for the center of the robot
  float radius; // the radius of the robot;
  PGraphics robotPG;
 
  Robot(float x, float y, int radius){
    this.x = x;
    this.y = y;
    this.radius = radius;
    robotPG = createGraphics(width,height);
  }
  void move(float toX, float toY){
    this.x = toX;
    this.y = toY;
    this.robotPG.beginDraw();
    this.robotPG.background(backgroundColor);
    this.robotPG.fill(0);
    this.robotPG.circle(this.x,this.y,this.radius);
    this.robotPG.endDraw();
    
  }
  float getX(){
    return this.x;
  }
  float getY(){
    return this.y;
  }
  PGraphics graphics(){
    return robotPG; 
  }
}

class Tracing{
  float previousX;
  float previousY;
  PGraphics tracingPG;
  
  Tracing(float previousX, float previousY){
    this.previousX = previousX;
    this.previousY = previousY;
    tracingPG = createGraphics(width,height);
    this.tracingPG.beginDraw();
    this.tracingPG.fill(0);
    this.tracingPG.circle(previousX,previousY,5);
    this.tracingPG.endDraw();
  }
  void drawTrace(float x, float y){
    if(sqrt(sq(x-this.previousX) + sq(y - this.previousY)) > 10){
      this.tracingPG.beginDraw();
      this.tracingPG.fill(0);
      this.tracingPG.circle(previousX,previousY,2);
      this.tracingPG.endDraw();
      this.previousX = x;
      this.previousY = y;
    }
  }
  
    PGraphics graphics(){
    return tracingPG;
  }
}

float[] splitMessage(String message,char c){
  float x,y,theta,t;
  try{
    int ind1 = message.indexOf(',');
    x = parseInt(message.substring(0,ind1));
    int ind2 = message.indexOf(',',ind1+1);
    y = parseInt(message.substring(ind1+1,ind2));
    int ind3 = message.indexOf(',',ind2+1);
    t = parseInt(message.substring(ind2+1,ind3));
    float result[] = {x,y,t};
    return result;
  }catch(Exception e){
    float result[] = {-1};
    return result;
  }
}
