MrEngineerET/roboClean/(commit log)

2020-10-11 arduino nano, SG90 servo and HC-SR04 datasheet and documents are collected
2020-10-11 servo and ultrasonic initial code is written
2020-10-11 documents for Odometry, Differential drive, and Similar research paper on autonomous robot is added
2020-10-24 speed sensor interrupt test code is added, speed sensor and geared motor datasheet is added
2020-10-25 motor test, individual wheel distance traveled test, velocity of each wheel test, and odometry of the robot is implemented
2020-10-25 correction is made to the assignment of the previousTimeSample variable
    [DrAndDl.ino, VrAndVlAndW.ino, interruptTest.ino, xAndYAndPhi.ino]
2020-10-25 correction made for the calculation of velocity
    [VrAndVlAndW.ino]
2020-10-26 a new file VrAndVlAndwithSmoother is added which has a median filter to calculte the velocity and angular velocity of the robot
2020-10-27 REncoder and LEncoder interrupt service routine is modified for all file and goToGoal sketch is in progress
2020-11-08 goToGoal version 2 code is written, this version rotate the robot with zero velocity for angles larger than pi/8 and for angle less than pi/8 PID controller is used
2020-11-17 bugs and small change is made to go to goal sketches
    [arduino2esp.ino, esp2arduinoSerial.ino, goToGoal.ino, goToGoalv2.ino, goToGoalv3.ino, motorTest.ino]
2020-11-17 gotogoal wireless sketch is added and also a sketch for Node MCU ESP8266 serveSYtheta is written
2020-11-20 motor speed test script and sketch is writeen
2020-11-21 ultrasonic and servo code is written for simulating a radar behaviour
2020-12-03 ultrasonicAndServo radar testing code is written
    [Biruk dust bin.SLDASM, draw.SLDPRT, vacume.SLDPRT]
2020-12-10 (1) correction is made on the usage of delta (2)left motor shild position is changed from 3 to 1 (3)web ui stop button is added (4) right motor PWM value is made to excced from the left motor by 30.
    [VrAndVlAndW.ino, VrAndVlAndWwireless.ino, VrAndVlAndWwithSmoother.ino, goToGoal.ino, goToGoalWireless.ino, goToGoalv2.ino]
