MrEngineerET/roboClean/Documentation/Images/Progress/Hardware/phase two/20201108_232054.jpg

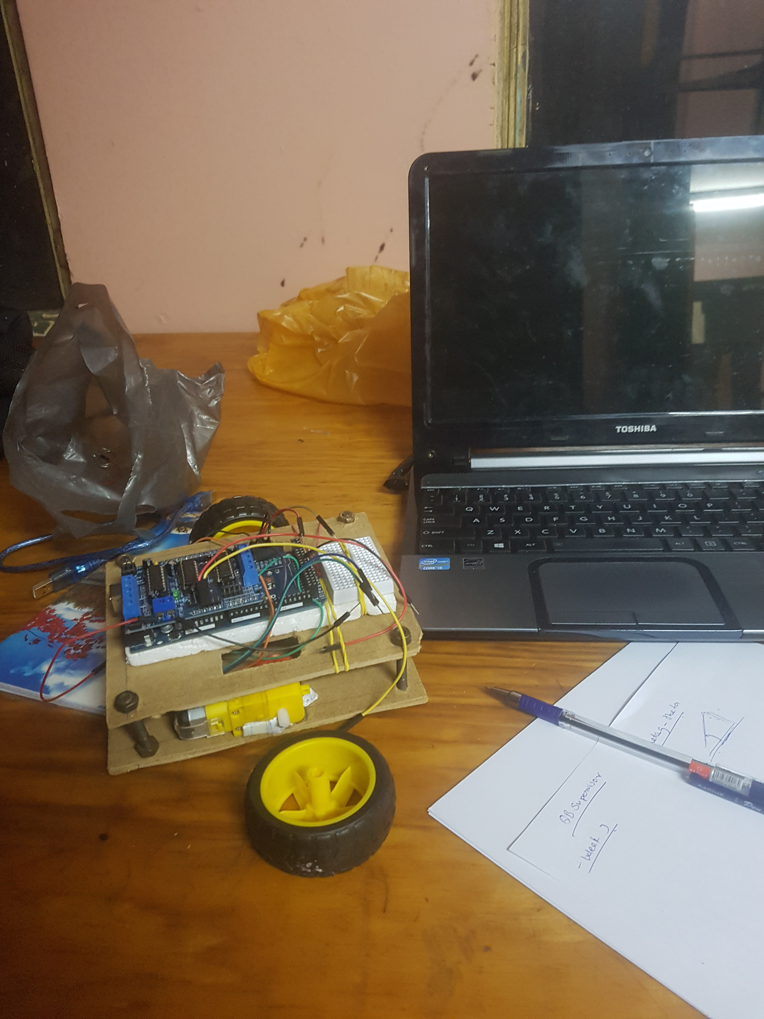
Documentation/Images/Progress/Hardware/phase two/20201108_232054.jpg
